smartrobolab/Coco_Desk_Buddy/coco_voice_c3/images/coco_voice_c3_bending_template.pdf

### COCO VOICE C3 - 1:1 bending template

Print at 100 % (no 'fit to page'). Check: the 50 mm ruler below must measure 50 mm.

50 mm

FRONT rectangle + divider (1.2 mm)

BACK rectangle + divider (1.2 mm)

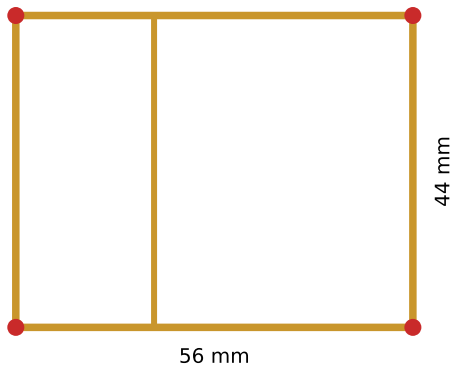
[picture p65: figure]
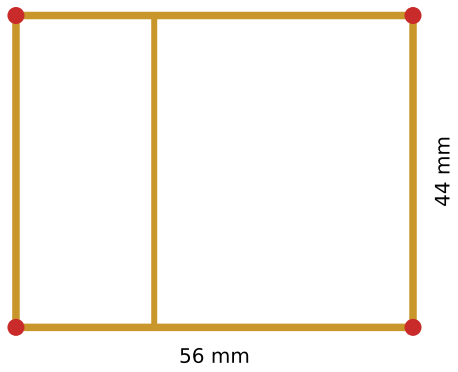
[picture p66: figure]

Red dots = 90° bends. Start a rectangle in the middle of the bottom side so the joint is hidden.

strut 30 mm x4 (1.2 mm)

divider 44 mm x2 (1.2 mm)

seat / floor bar 36.5 mm (see case drawing)

battery ring Ø17.2 mm x2 - wrap the wire around a 16 mm rod (a spare 16340 in its wrap works) and leave a 3 mm tab.

OLED outline 27.3 x 27.8 mm with its 4 mounting holes.
Measure your module: hole spacing varies (about 23 x 24 mm). Posts: 0.9 mm wire through each hole, soldered to the front frame.
