smartrobolab/Coco_Desk_Buddy/coco_touch_advance/yeti_403035/images/coco_yeti_render.png

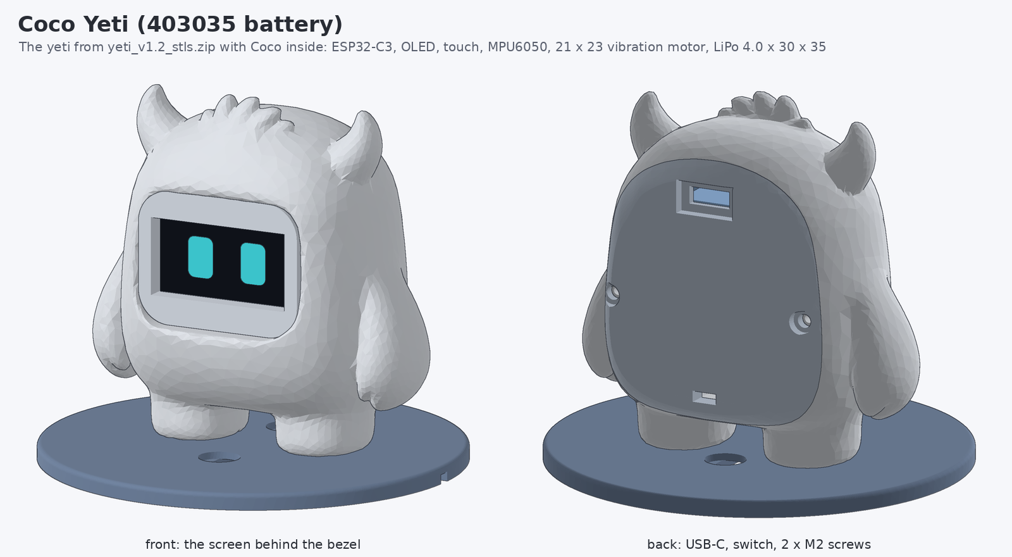
coco_touch_advance/yeti_403035/images/coco_yeti_render.png
