smartrobolab/Coco_Desk_Buddy/coco_touch_advance/yeti_403048/images/coco_yeti_colour_options.png

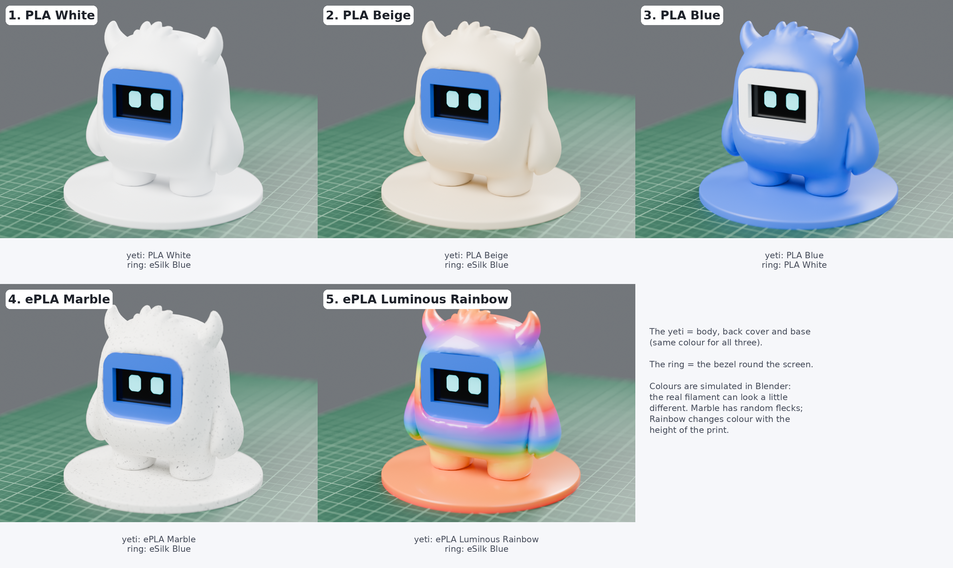
coco_touch_advance/yeti_403048/images/coco_yeti_colour_options.png
