smartrobolab/Coco_Desk_Buddy/shared/images/screens/card_boot.gif

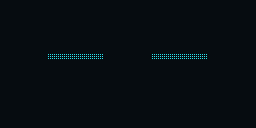
shared/images/screens/card_boot.gif
