smartrobolab/Coco_Desk_Buddy/shared/images/screens/card_boot.png

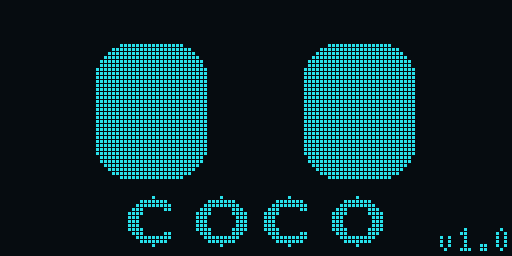
shared/images/screens/card_boot.png
