smartrobolab/Coco_Desk_Buddy/shared/images/screens/card_clock.png

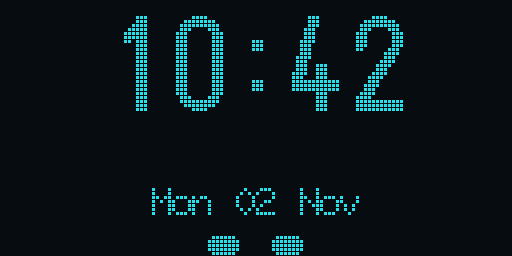
shared/images/screens/card_clock.png
