smartrobolab/Coco_Desk_Buddy/shared/images/screens/card_hold.png

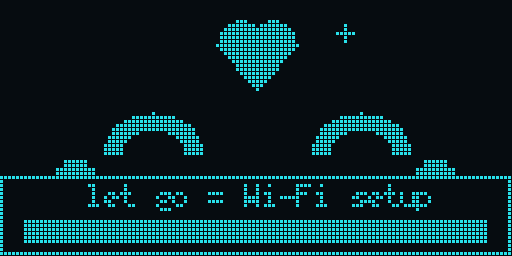
shared/images/screens/card_hold.png
