smartrobolab/Coco_Desk_Buddy/shared/images/screens/card_noweather.png

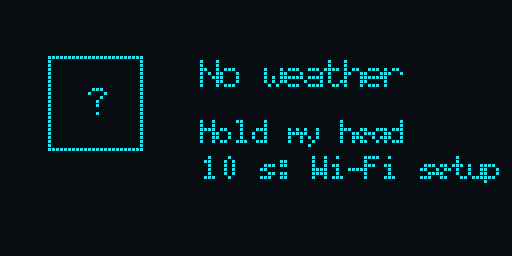
shared/images/screens/card_noweather.png
