smartrobolab/Coco_Desk_Buddy/shared/images/screens/card_status.png

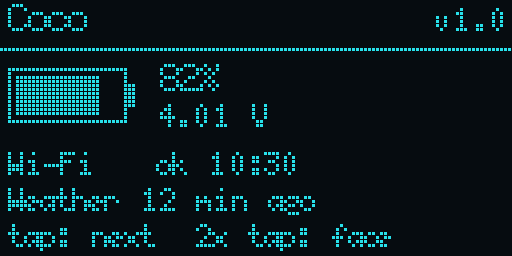
shared/images/screens/card_status.png
