smartrobolab/Coco_Desk_Buddy/shared/images/screens/card_weather-clear.gif

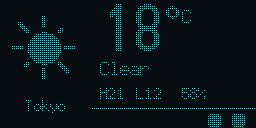
shared/images/screens/card_weather-clear.gif
