smartrobolab/Coco_Desk_Buddy/shared/images/screens/card_weather-fog.png

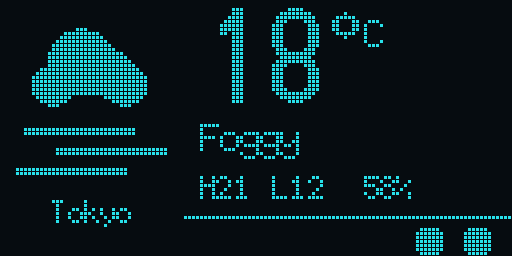
shared/images/screens/card_weather-fog.png
