smartrobolab/Coco_Desk_Buddy/shared/images/screens/card_weather-night.png

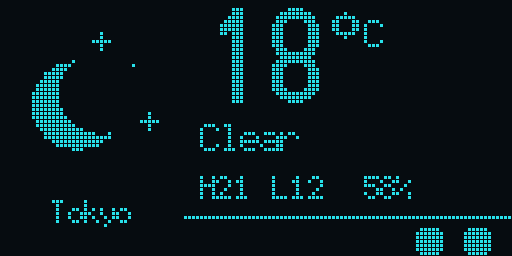
shared/images/screens/card_weather-night.png
