smartrobolab/Coco_Desk_Buddy/shared/images/screens/card_weather-partly.png

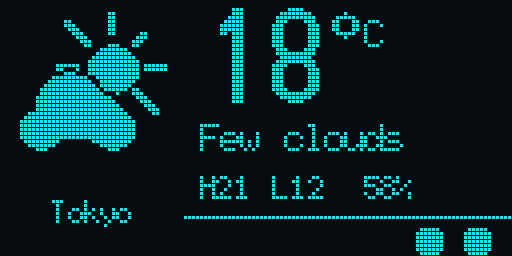
shared/images/screens/card_weather-partly.png
