smartrobolab/Coco_Desk_Buddy/shared/images/screens/card_weather-snow.png

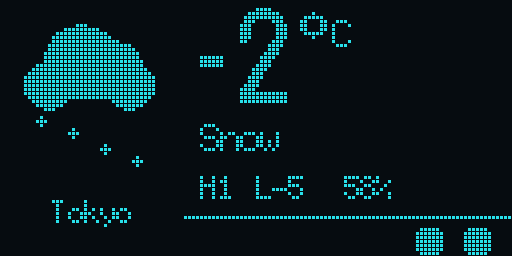
shared/images/screens/card_weather-snow.png
