smartrobolab/Coco_Desk_Buddy/shared/images/screens/card_wifi2.png

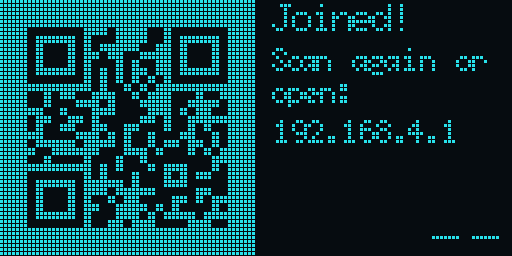
shared/images/screens/card_wifi2.png
