smartrobolab/Coco_Desk_Buddy/shared/images/screens/card_wifi.png

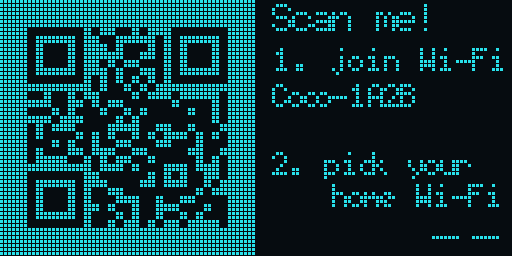
shared/images/screens/card_wifi.png
