smartrobolab/Coco_Desk_Buddy/shared/images/screens/card_wififail.png

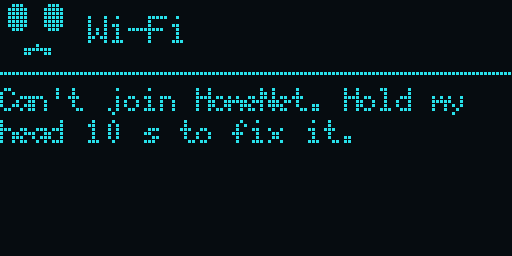
shared/images/screens/card_wififail.png
