smartrobolab/Coco_Desk_Buddy/shared/images/screens/face_angry.png

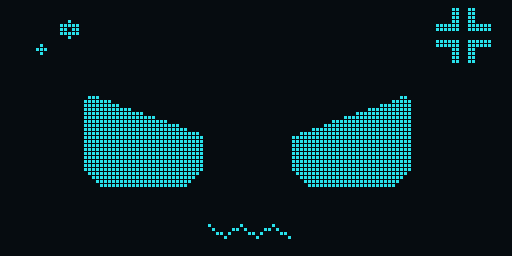
shared/images/screens/face_angry.png
