smartrobolab/Coco_Desk_Buddy/shared/images/screens/face_anime_love.gif

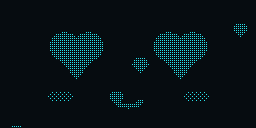
shared/images/screens/face_anime_love.gif
