smartrobolab/Coco_Desk_Buddy/shared/images/screens/face_anime_love.png

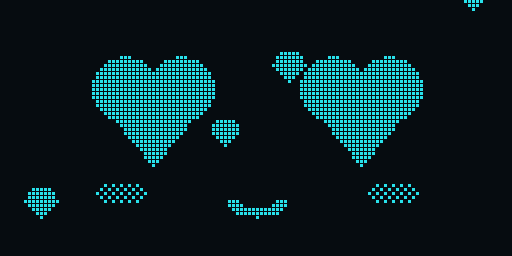
shared/images/screens/face_anime_love.png
