smartrobolab/Coco_Desk_Buddy/shared/images/screens/face_crying.png

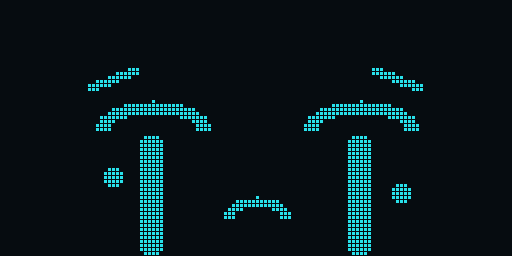
shared/images/screens/face_crying.png
