smartrobolab/Coco_Desk_Buddy/shared/images/screens/face_cute.png

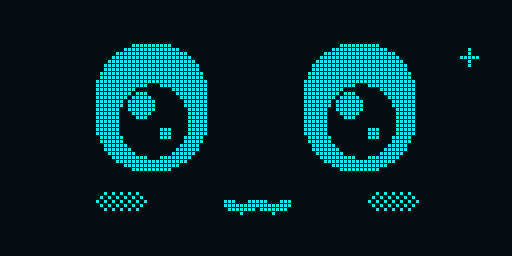
shared/images/screens/face_cute.png
