smartrobolab/Coco_Desk_Buddy/shared/images/screens/face_dizzy.png

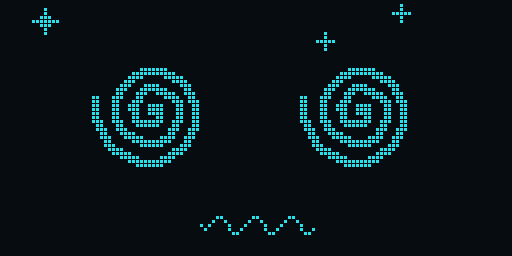
shared/images/screens/face_dizzy.png
