smartrobolab/Coco_Desk_Buddy/shared/images/screens/face_eating.gif

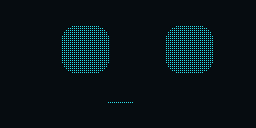
shared/images/screens/face_eating.gif
