smartrobolab/Coco_Desk_Buddy/shared/images/screens/face_eating.png

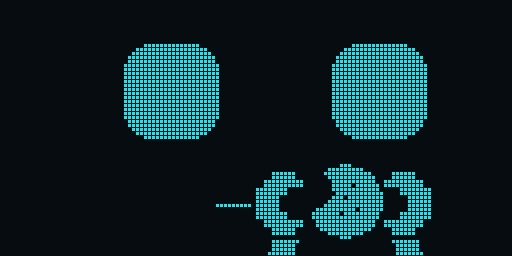
shared/images/screens/face_eating.png
