smartrobolab/Coco_Desk_Buddy/shared/images/screens/face_fire.png

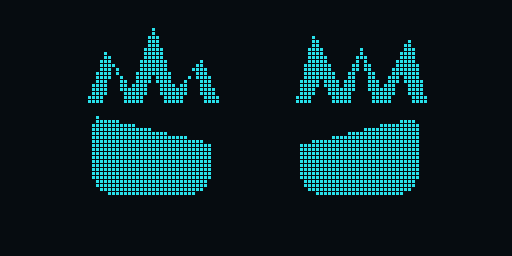
shared/images/screens/face_fire.png
