smartrobolab/Coco_Desk_Buddy/shared/images/screens/face_happy.png

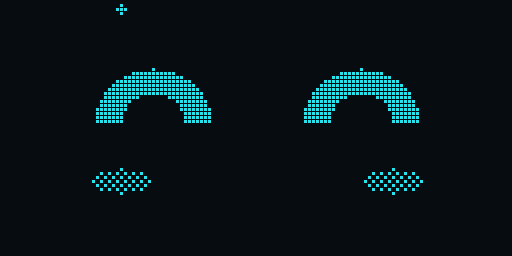
shared/images/screens/face_happy.png
