smartrobolab/Coco_Desk_Buddy/shared/images/screens/face_kissou.png

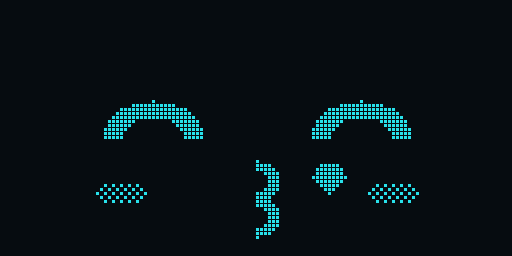
shared/images/screens/face_kissou.png
