smartrobolab/Coco_Desk_Buddy/shared/images/screens/face_low_battery.png

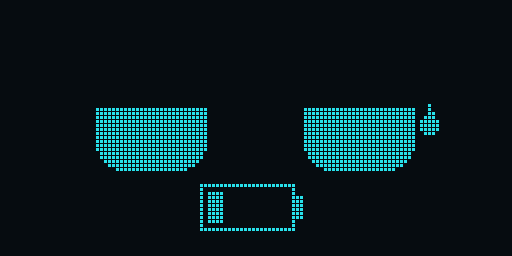
shared/images/screens/face_low_battery.png
