smartrobolab/Coco_Desk_Buddy/shared/images/screens/face_mini_love.png

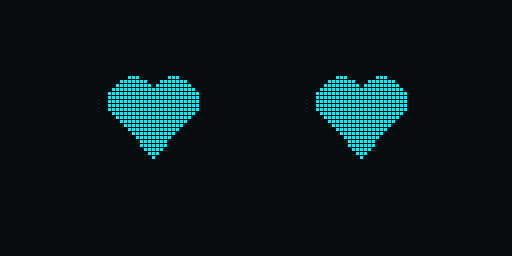
shared/images/screens/face_mini_love.png
