smartrobolab/Coco_Desk_Buddy/shared/images/screens/face_music.png

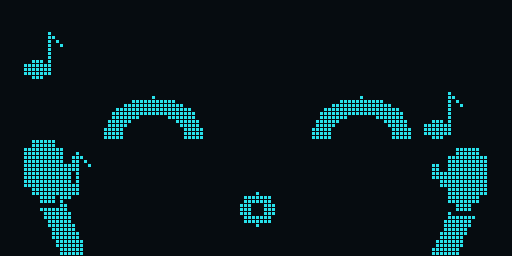
shared/images/screens/face_music.png
