smartrobolab/Coco_Desk_Buddy/shared/images/screens/face_neutral.gif

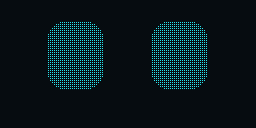
shared/images/screens/face_neutral.gif
