smartrobolab/Coco_Desk_Buddy/shared/images/screens/face_playing.png

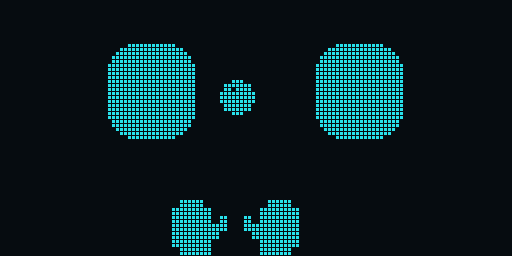
shared/images/screens/face_playing.png
