smartrobolab/Coco_Desk_Buddy/shared/images/screens/face_sad.png

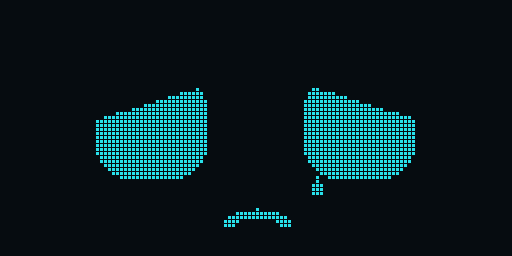
shared/images/screens/face_sad.png
