smartrobolab/Coco_Desk_Buddy/shared/images/screens/face_serious.png

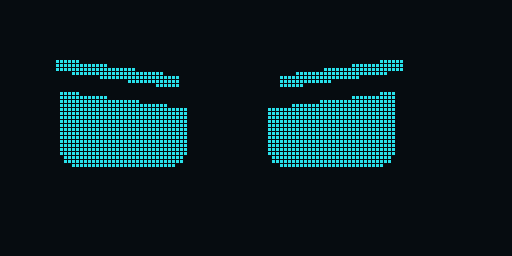
shared/images/screens/face_serious.png
