smartrobolab/Coco_Desk_Buddy/shared/images/screens/face_singing.png

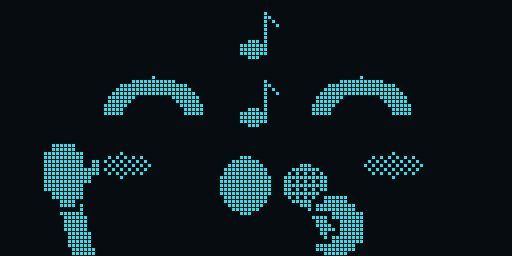
shared/images/screens/face_singing.png
