smartrobolab/Coco_Desk_Buddy/shared/images/screens/face_sleeping.png

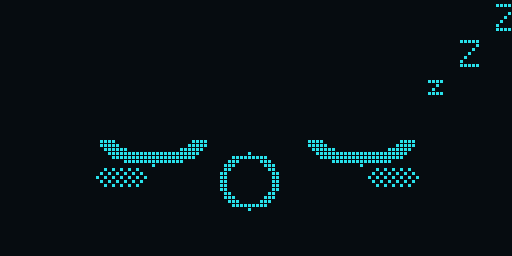
shared/images/screens/face_sleeping.png
