smartrobolab/Coco_Desk_Buddy/shared/images/screens/face_sleepy.png

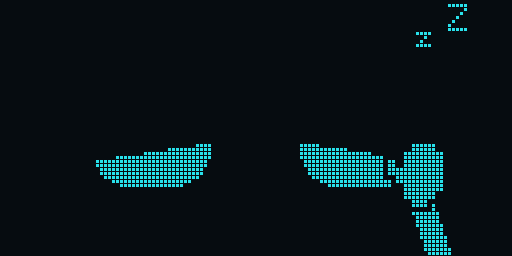
shared/images/screens/face_sleepy.png
