smartrobolab/Coco_Desk_Buddy/shared/images/screens/face_surprised.png

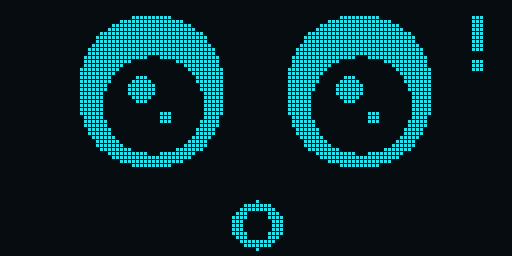
shared/images/screens/face_surprised.png
