smartrobolab/Coco_Desk_Buddy/shared/images/screens/face_yawn.png

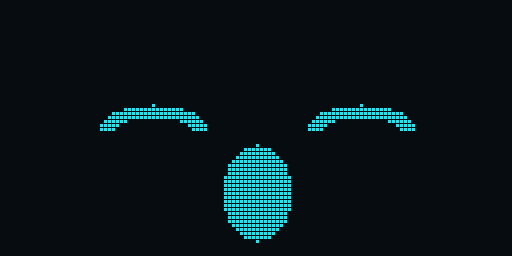
shared/images/screens/face_yawn.png
