smartrobolab/Coco_Desk_Buddy/coco_voice_c3/cad/coco_voice_c3_full.stl

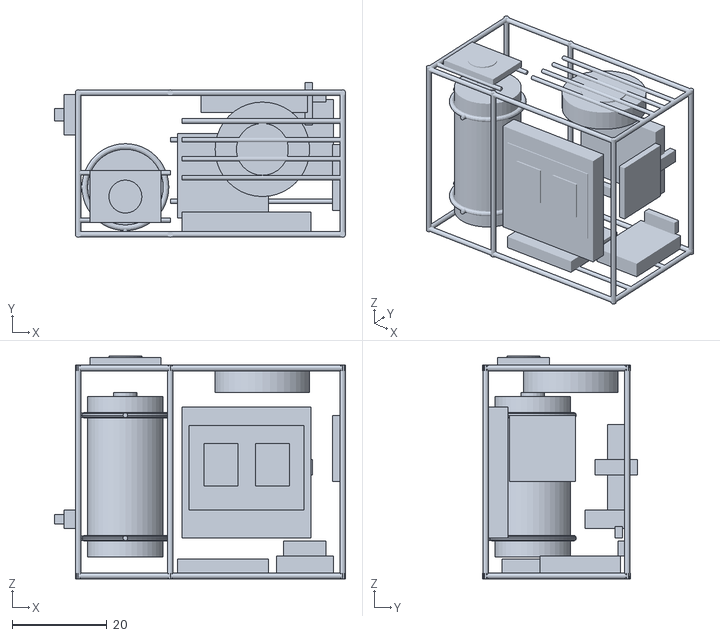
[picture p109: CAD file, 2026-11-02]
coco_voice_c3/cad/coco_voice_c3_full.stl
61.6 x 32.7 x 47.1
