smartrobolab/Coco_Desk_Buddy/coco_touch/cad/coco_touch_full.stl

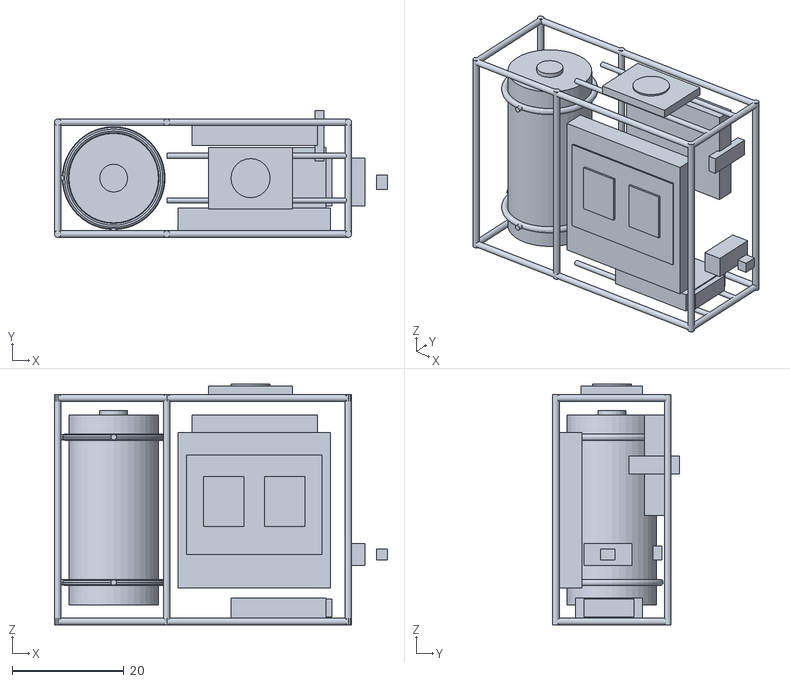
[picture p110: CAD file, 2026-11-02]
coco_touch/cad/coco_touch_full.stl
59.6 x 22.7 x 43.1
