smartrobolab/Coco_Desk_Buddy/coco_voice_s3/cad/coco_voice_s3_hw747_esp32s3_full.stl

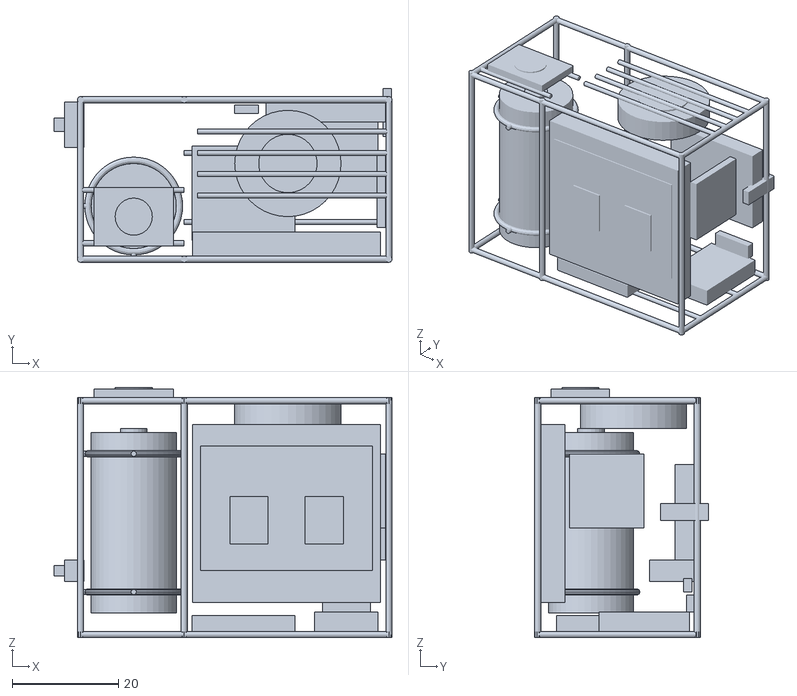
[picture p111: CAD file, 2026-11-03]
coco_voice_s3/cad/coco_voice_s3_hw747_esp32s3_full.stl
63.6 x 32.7 x 47.1
