smartrobolab/Coco_Desk_Buddy/coco_touch/cad/coco_touch_frame.stl

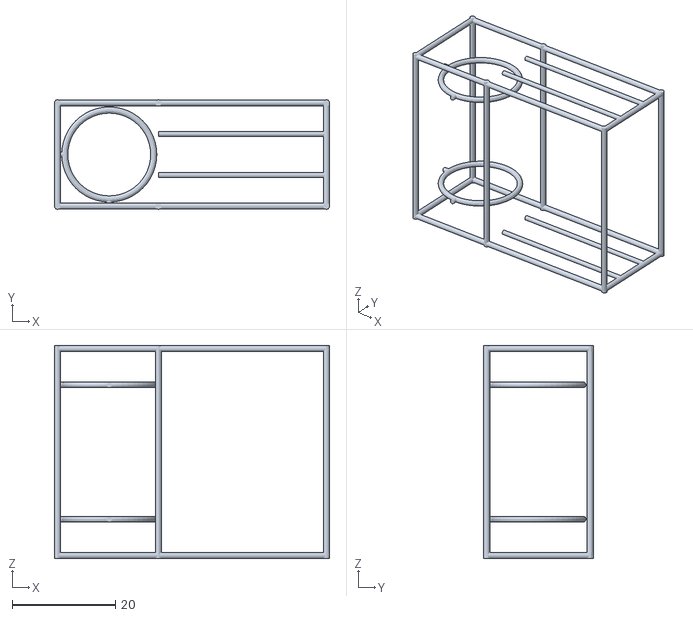
[picture p112: CAD file, 2026-11-02]
coco_touch/cad/coco_touch_frame.stl
53.2 x 21.2 x 41.2
