smartrobolab/Coco_Desk_Buddy/coco_touch_advance/yeti/cad/coco_yeti_base_plain.stl

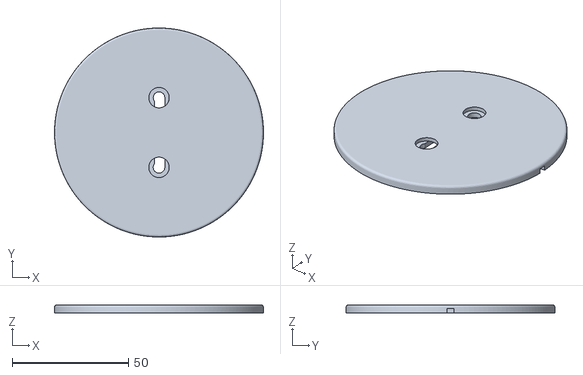
[picture p113: CAD file, 2026-11-04]
coco_touch_advance/yeti/cad/coco_yeti_base_plain.stl
90.0 x 90.0 x 3.50
