smartrobolab/Coco_Desk_Buddy/coco_touch_advance/yeti_403035/cad/coco_yeti_bezel_096.stl

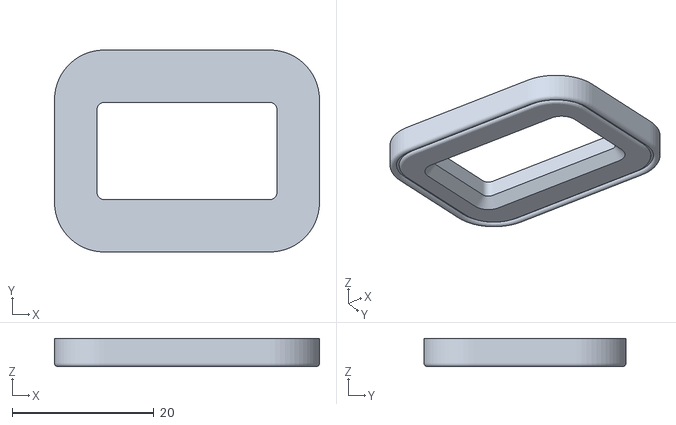
[picture p114: CAD file, 2026-11-04]
coco_touch_advance/yeti_403035/cad/coco_yeti_bezel_096.stl
37.4 x 28.5 x 4.00
