smartrobolab/Coco_Desk_Buddy/coco_touch_advance/yeti_403048/cad/coco_yeti_base_plain.stl

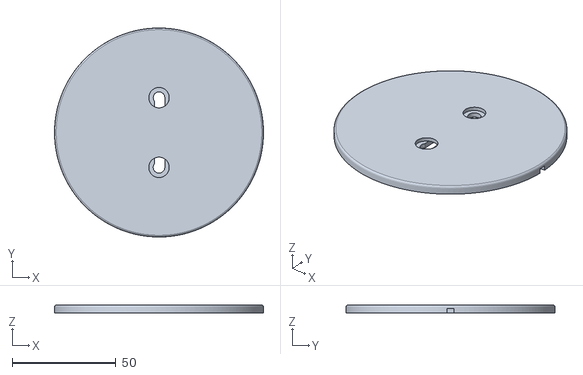
[picture p115: CAD file, 2026-11-04]
coco_touch_advance/yeti_403048/cad/coco_yeti_base_plain.stl
100.8 x 100.8 x 3.87
