smartrobolab/Coco_Desk_Buddy/coco_voice_s3/cad/coco_voice_s3_hw747_esp32s3_frame.stl

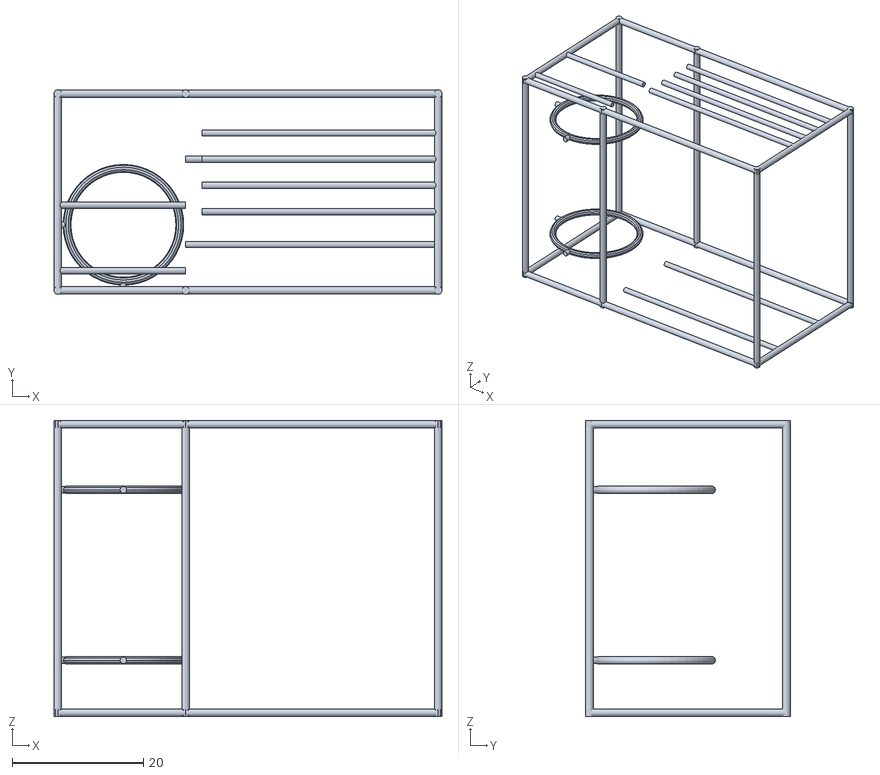
[picture p116: CAD file, 2026-11-03]
coco_voice_s3/cad/coco_voice_s3_hw747_esp32s3_frame.stl
59.2 x 31.2 x 45.2
