smartrobolab/Coco_Desk_Buddy/coco_touch_advance/yeti/cad/coco_yeti_back_cover.stl

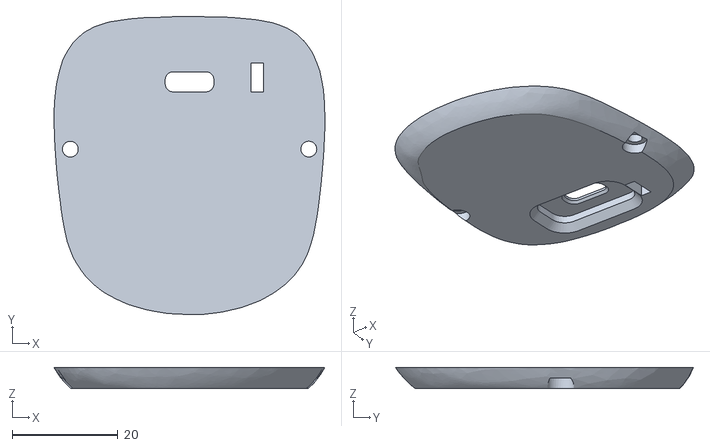
[picture p117: CAD file, 2026-11-04]
coco_touch_advance/yeti/cad/coco_yeti_back_cover.stl
51.1 x 56.2 x 4.00
