smartrobolab/Coco_Desk_Buddy/coco_touch_advance/yeti_2x502030/cad/coco_yeti_chassis_13.stl

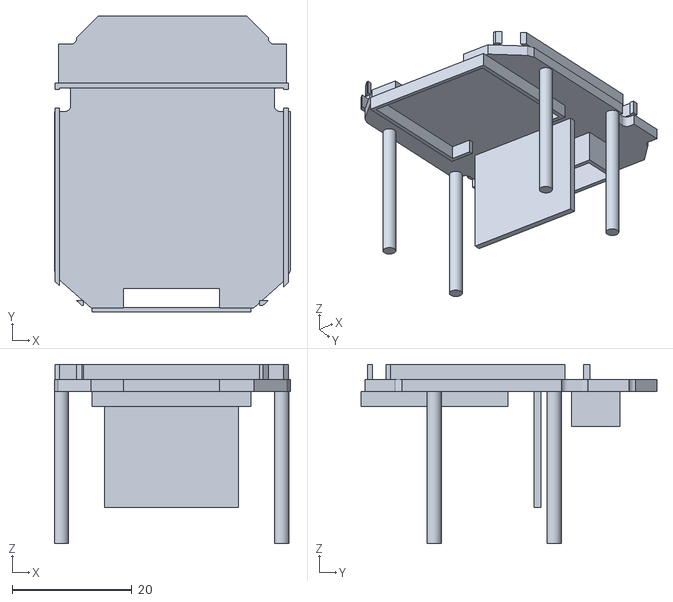
[picture p118: CAD file, 2026-11-04]
coco_touch_advance/yeti_2x502030/cad/coco_yeti_chassis_13.stl
39.4 x 49.4 x 29.9
