smartrobolab/Coco_Desk_Buddy/coco_touch_advance/yeti_403048/cad/coco_yeti_back_cover.stl

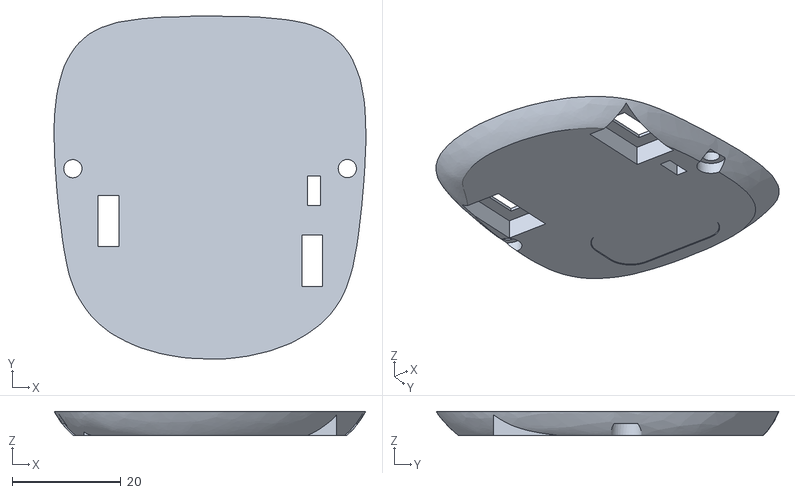
[picture p120: CAD file, 2026-11-04]
coco_touch_advance/yeti_403048/cad/coco_yeti_back_cover.stl
57.3 x 63.0 x 4.48
