smartrobolab/Coco_Desk_Buddy/coco_voice_c3/cad/coco_voice_c3_frame.stl

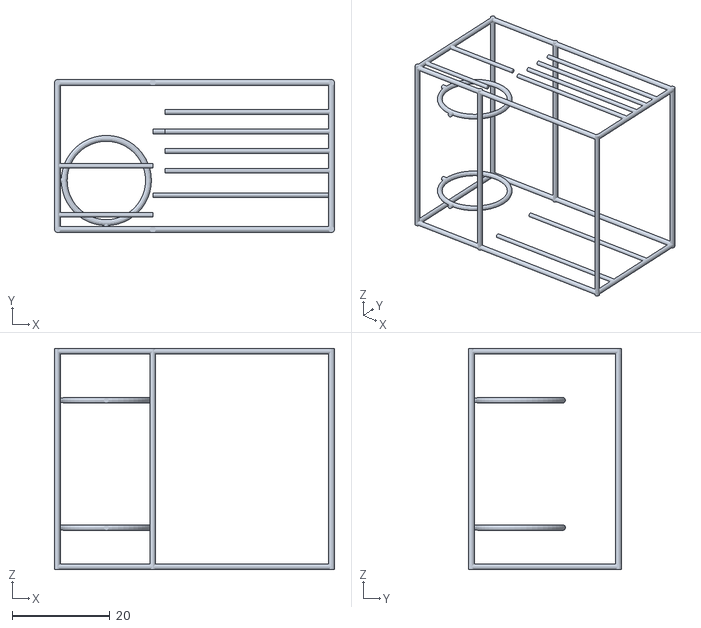
[picture p121: CAD file, 2026-11-02]
coco_voice_c3/cad/coco_voice_c3_frame.stl
57.2 x 31.2 x 45.2
