smartrobolab/Coco_Desk_Buddy/coco_touch_advance/yeti/cad/coco_yeti_body.stl

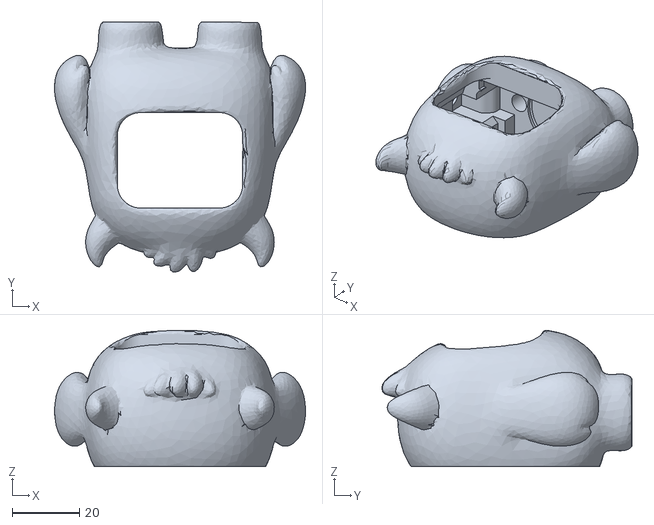
[picture p122: CAD file, 2026-11-04]
coco_touch_advance/yeti/cad/coco_yeti_body.stl
74.9 x 74.7 x 40.6
