smartrobolab/Coco_Desk_Buddy/coco_touch_advance/yeti_2x502030/cad/coco_yeti_chassis_096.stl

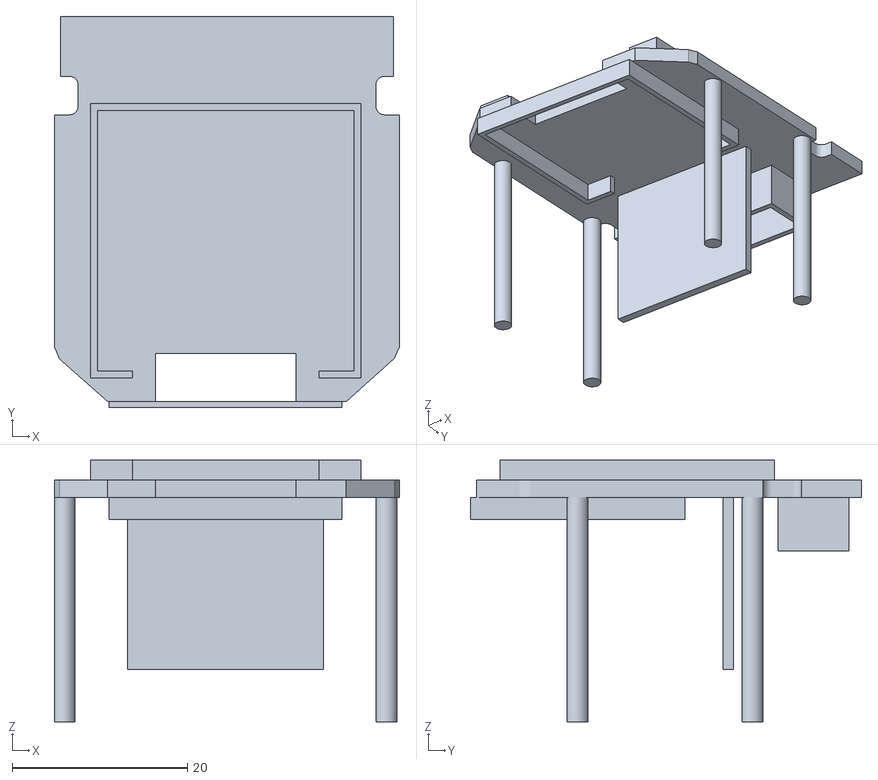
[picture p123: CAD file, 2026-11-04]
coco_touch_advance/yeti_2x502030/cad/coco_yeti_chassis_096.stl
39.4 x 44.7 x 29.9
