smartrobolab/Coco_Desk_Buddy/coco_touch_advance/yeti/cad/coco_yeti_parts_13.stl

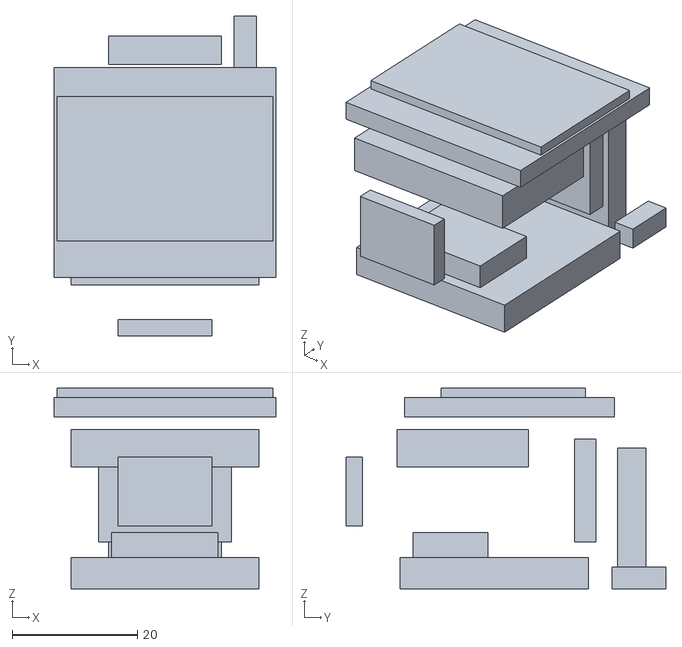
[picture p128: CAD file, 2026-11-04]
coco_touch_advance/yeti/cad/coco_yeti_parts_13.stl
35.4 x 51.0 x 32.0
