smartrobolab/Coco_Desk_Buddy/coco_touch_advance/yeti_2x502030/cad/coco_yeti_parts_13.stl

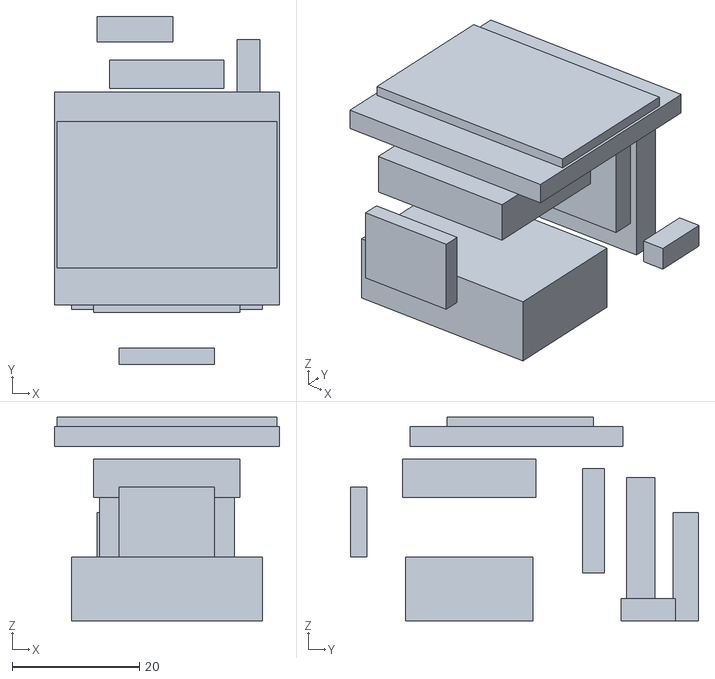
[picture p129: CAD file, 2026-11-04]
coco_touch_advance/yeti_2x502030/cad/coco_yeti_parts_13.stl
35.4 x 54.6 x 32.0
