smartrobolab/Coco_Desk_Buddy/coco_touch_advance/yeti_403035/cad/coco_yeti_chassis_13.stl

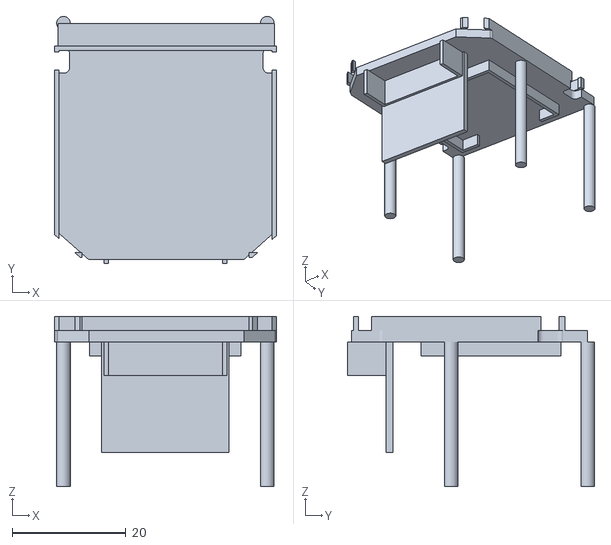
[picture p130: CAD file, 2026-11-04]
coco_touch_advance/yeti_403035/cad/coco_yeti_chassis_13.stl
39.0 x 43.4 x 29.9
