smartrobolab/Coco_Desk_Buddy/coco_touch_advance/yeti_403048/cad/coco_yeti_bezel_096.stl

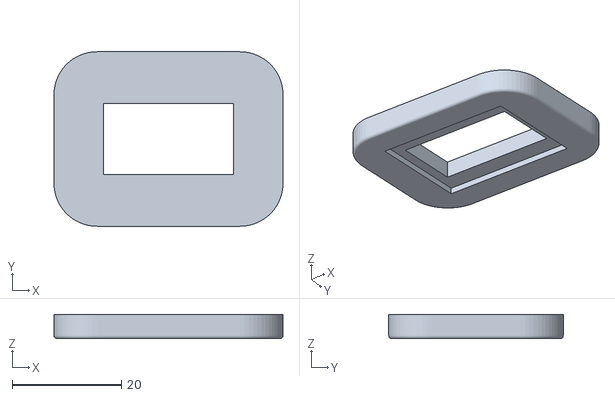
[picture p131: CAD file, 2026-11-04]
coco_touch_advance/yeti_403048/cad/coco_yeti_bezel_096.stl
41.9 x 31.9 x 4.48
