smartrobolab/Coco_Desk_Buddy/coco_touch_advance/yeti/cad/coco_yeti_parts_096.stl

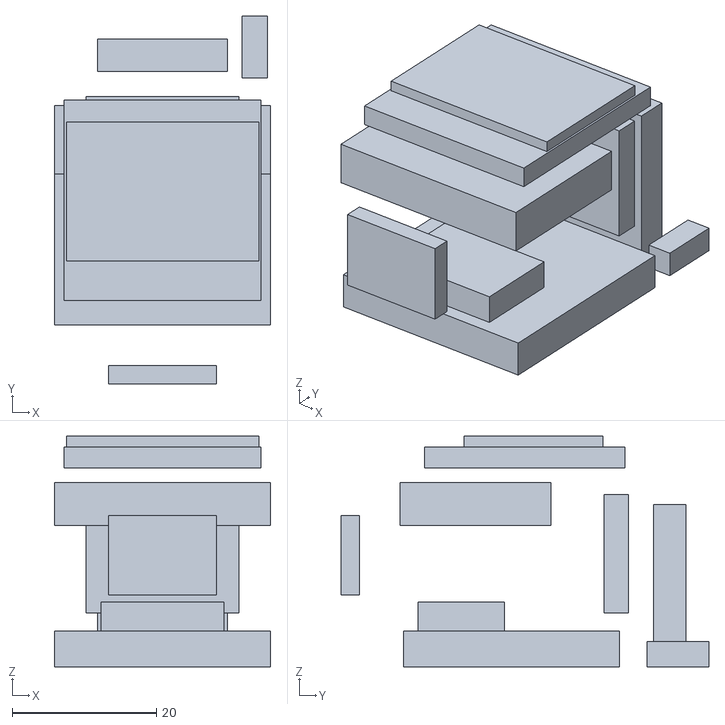
[picture p132: CAD file, 2026-11-04]
coco_touch_advance/yeti/cad/coco_yeti_parts_096.stl
30.0 x 51.0 x 32.0
