smartrobolab/Coco_Desk_Buddy/coco_touch_advance/yeti/cad/coco_yeti_bezel_13.stl

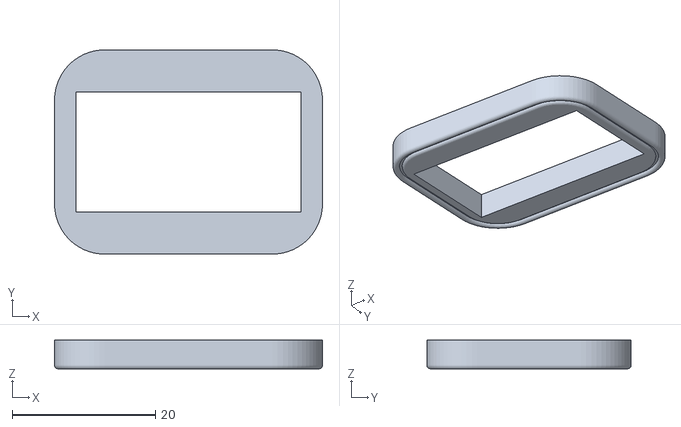
[picture p134: CAD file, 2026-11-04]
coco_touch_advance/yeti/cad/coco_yeti_bezel_13.stl
37.4 x 28.5 x 4.00
