smartrobolab/Coco_Desk_Buddy/coco_touch_advance/yeti_403048/cad/coco_yeti_parts_096.stl

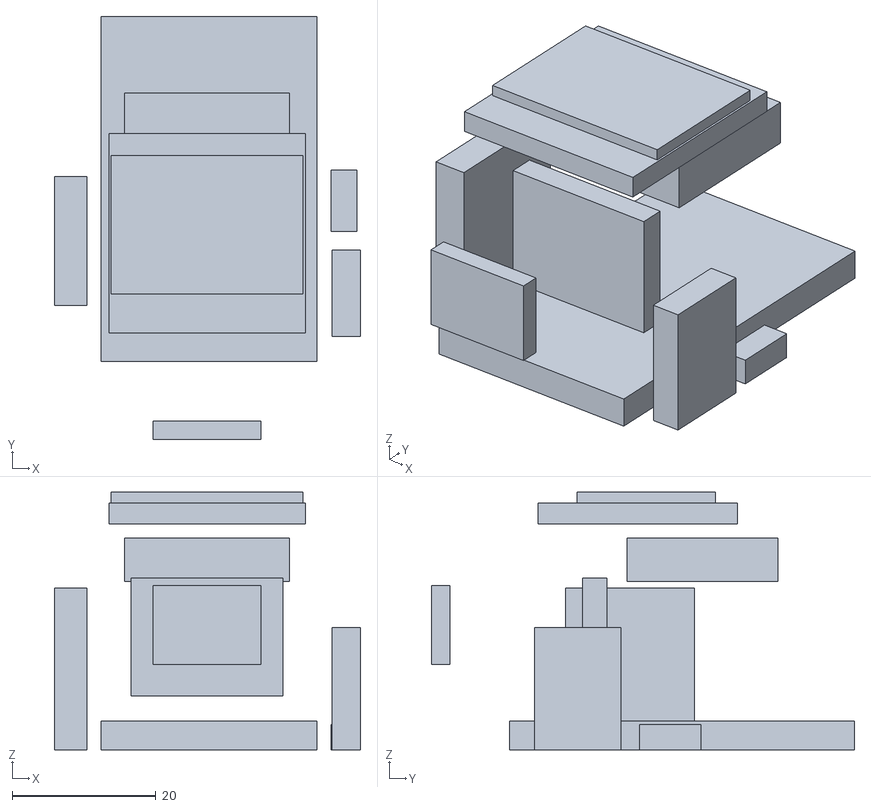
[picture p136: CAD file, 2026-11-04]
coco_touch_advance/yeti_403048/cad/coco_yeti_parts_096.stl
42.6 x 58.9 x 35.8
