smartrobolab/Coco_Desk_Buddy/coco_touch_advance/yeti_2x502030/cad/coco_yeti_parts_096.stl

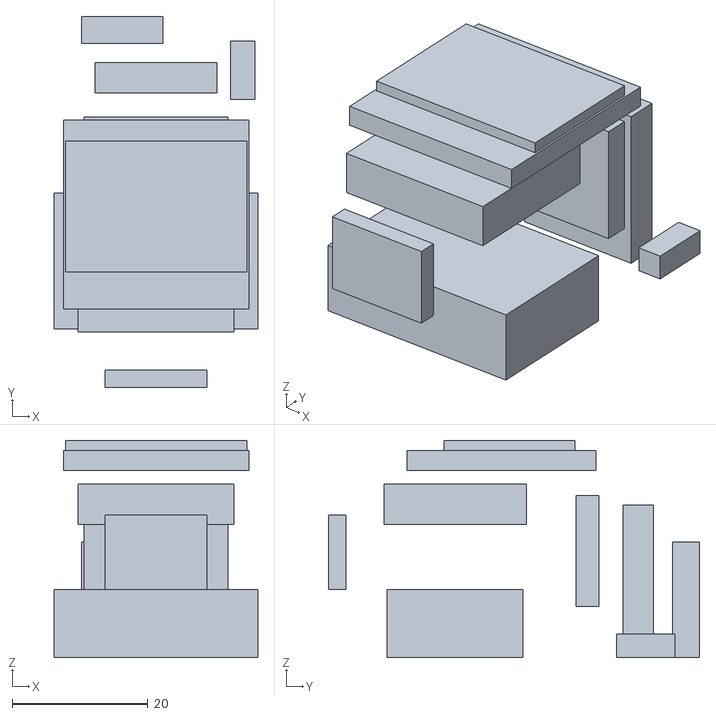
[picture p138: CAD file, 2026-11-04]
coco_touch_advance/yeti_2x502030/cad/coco_yeti_parts_096.stl
30.0 x 54.6 x 32.0
