smartrobolab/Coco_Desk_Buddy/coco_touch_advance/yeti_403035/cad/coco_yeti_chassis_096.stl

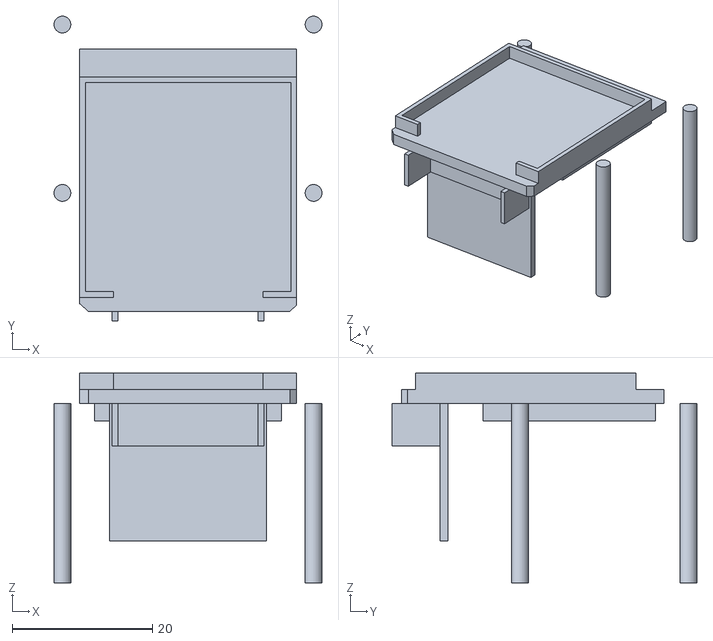
[picture p139: CAD file, 2026-11-04]
coco_touch_advance/yeti_403035/cad/coco_yeti_chassis_096.stl
38.2 x 43.4 x 29.9
