smartrobolab/Coco_Desk_Buddy/coco_touch_advance/yeti_403048/cad/coco_yeti_chassis_13.stl

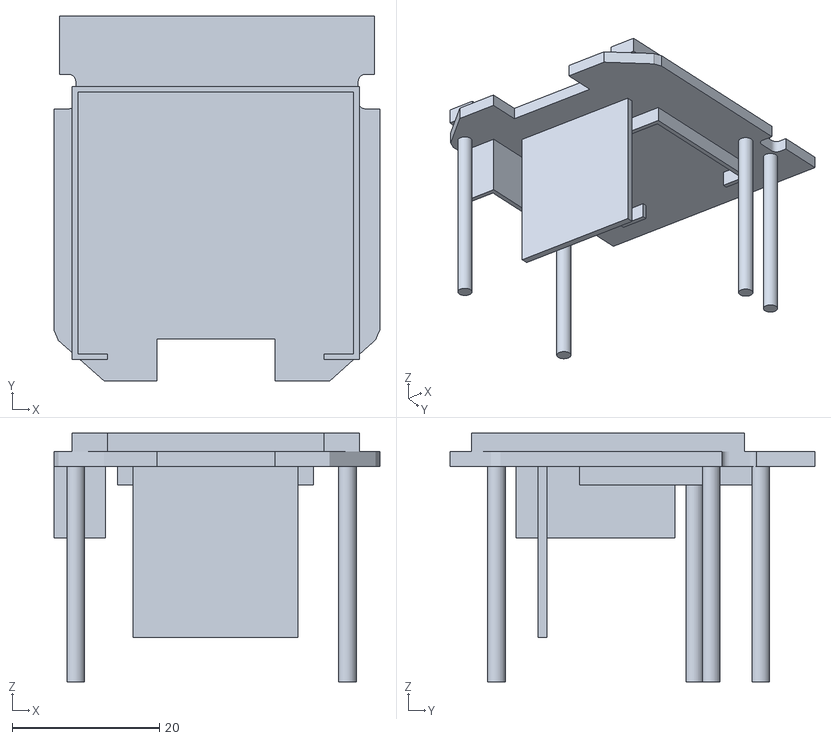
[picture p140: CAD file, 2026-11-04]
coco_touch_advance/yeti_403048/cad/coco_yeti_chassis_13.stl
44.2 x 49.5 x 33.7
