smartrobolab/Coco_Desk_Buddy/coco_touch_advance/yeti/cad/coco_yeti_chassis_096.stl

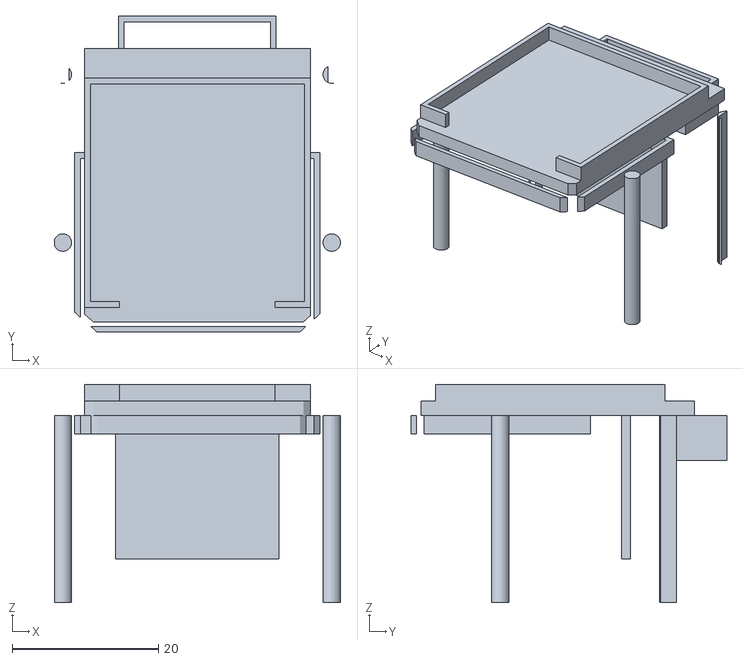
[picture p141: CAD file, 2026-11-04]
coco_touch_advance/yeti/cad/coco_yeti_chassis_096.stl
39.1 x 43.2 x 29.9
