smartrobolab/Coco_Desk_Buddy/coco_touch_advance/yeti_403048/cad/coco_yeti_body.stl

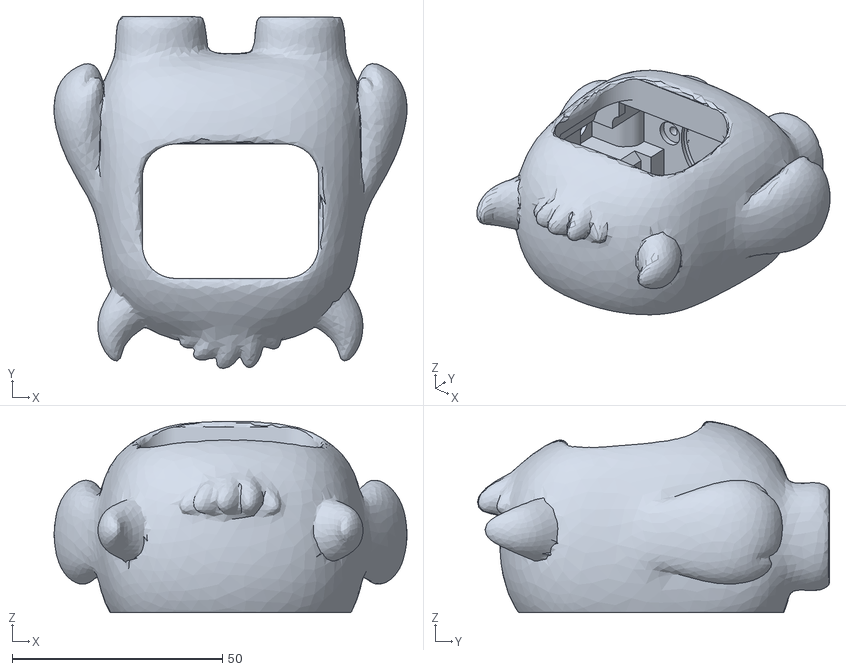
[picture p143: CAD file, 2026-11-04]
coco_touch_advance/yeti_403048/cad/coco_yeti_body.stl
83.9 x 83.7 x 45.5
