smartrobolab/Coco_Desk_Buddy/(list of files, cad)

Other CAD files:
coco_voice_s3/cad/coco_voice_s3_full.stl
coco_touch_advance/yeti_2x502030/cad/coco_yeti_base_plain.stl
coco_voice_s3/cad/coco_voice_s3_frame.stl
coco_touch_advance/yeti_2x502030/cad/coco_yeti_back_cover.stl
coco_touch_advance/yeti_403035/cad/coco_yeti_back_cover.stl
coco_touch_advance/yeti_2x502030/cad/print/coco_yeti_back_cover.stl
coco_touch_advance/yeti_2x502030/cad/print/coco_yeti_base_plain.stl
coco_touch_advance/yeti_2x502030/cad/print/coco_yeti_bezel_096.stl
coco_touch_advance/yeti_2x502030/cad/print/coco_yeti_bezel_13.stl
coco_touch_advance/yeti_2x502030/cad/print/coco_yeti_body.stl
coco_touch_advance/yeti_2x502030/cad/print/coco_yeti_chassis_096.stl
coco_touch_advance/yeti_2x502030/cad/print/coco_yeti_chassis_13.stl
coco_touch_advance/yeti_403048/cad/print/coco_yeti_back_cover.stl
coco_touch_advance/yeti_403048/cad/print/coco_yeti_base_plain.stl
coco_touch_advance/yeti_403048/cad/print/coco_yeti_bezel_096.stl
coco_touch_advance/yeti_403048/cad/print/coco_yeti_bezel_13.stl
coco_touch_advance/yeti_403048/cad/print/coco_yeti_body.stl
coco_touch_advance/yeti_403048/cad/print/coco_yeti_chassis_096.stl
coco_touch_advance/yeti_403048/cad/print/coco_yeti_chassis_13.stl
