smartrobolab/Coco_Desk_Buddy/coco_voice_s3/images/coco_voice_s3_devkit_wiring.png

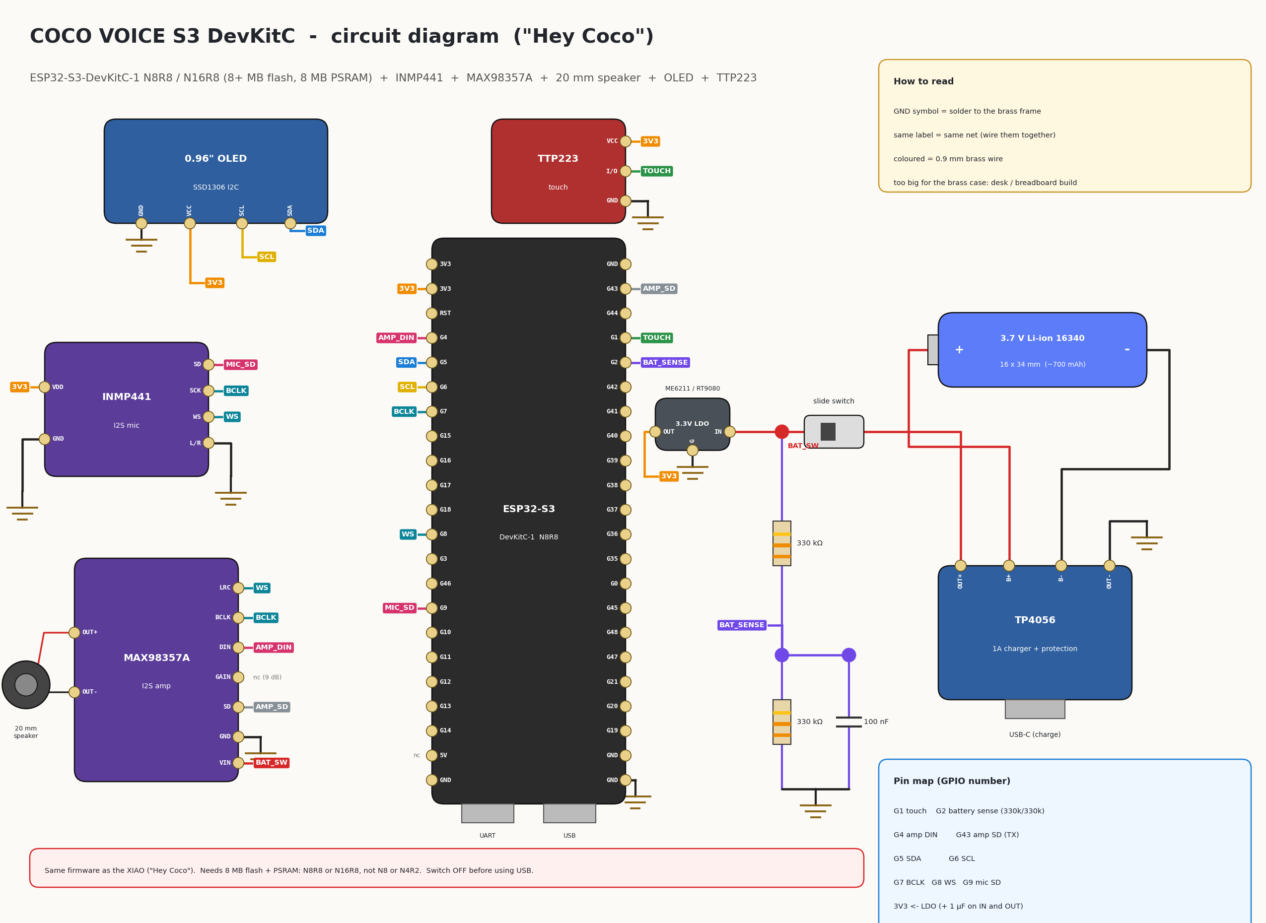
coco_voice_s3/images/coco_voice_s3_devkit_wiring.png
