smartrobolab/Coco_Desk_Buddy/coco_touch_advance/yeti_2x502030/cad/verify_report.txt

Coco Yeti print check: yeti_2x502030 (scale 1.00)

1. Printable files (cad/print/, as they go on the print bed)
   coco_yeti_back_cover.stl         OK  closed solid,  51.1 x  56.2 x   4.0 mm,   7.8 cm3, ~   8 g PLA
   coco_yeti_base_plain.stl         OK  closed solid,  90.0 x  90.0 x   3.5 mm,  21.1 cm3, ~  22 g PLA
   coco_yeti_bezel_096.stl          OK  closed solid,  37.4 x  28.5 x   4.0 mm,   2.6 cm3, ~   3 g PLA
   coco_yeti_bezel_13.stl           OK  closed solid,  37.4 x  28.5 x   4.0 mm,   1.6 cm3, ~   2 g PLA
   coco_yeti_body.stl               OK  closed solid,  74.9 x  74.7 x  40.6 mm,  37.8 cm3, ~  40 g PLA
   coco_yeti_chassis_096.stl        OK  closed solid,  39.4 x  44.7 x  29.9 mm,   4.8 cm3, ~   5 g PLA
   coco_yeti_chassis_13.stl         OK  closed solid,  39.4 x  49.4 x  29.9 mm,   5.1 cm3, ~   5 g PLA

2. Fit (1 mm round every part)
   13 screen: OK
   096 screen: OK

3. Yeti on the base
   overlap yeti / base: 0.000 mm3 (OK)
   foot at x   15.0, y   4.3: pilot hole open, leg 100% solid round it, base hole below it yes
   foot at x  -15.0, y   4.3: pilot hole open, leg 100% solid round it, base hole below it yes

4. USB-C ports (big plug: head 15 x 9 mm, metal 6.65 mm), pushed fully into each socket
   ESP32-C3 (program)   socket at x    0.0, y   15.3: plug head clear, metal goes 6.05 mm into the socket, socket behind the slot
   TP4056 (charge)      socket at x   -5.0, y   21.4: plug head clear, metal goes 6.05 mm into the socket, socket behind the slot
   both cables at once: no, one at a time (the plug heads would touch)

5. Stability (1.3" version; PLA, parts as weighed typically)
   total about 86 g, centre of mass at x 0.1, y 4.4 (back +), z 39.6 mm above the desk
   on its feet alone: centre of mass inside the feet, 10.2 mm from the nearest edge, tips over at ~16 deg of tilt
   screwed to the base: 44.9 mm to the base edge, tips over at ~49 deg of tilt

RESULT: all checks passed
