smartrobolab/Coco_Desk_Buddy/coco_touch_advance/yeti_403048/cad/verify_report.txt

Coco Yeti print check: yeti_403048 (scale 1.12)

1. Printable files (cad/print/, as they go on the print bed)
   coco_yeti_back_cover.stl         OK  closed solid,  57.3 x  63.0 x   4.5 mm,  11.3 cm3, ~  12 g PLA
   coco_yeti_base_plain.stl         OK  closed solid, 100.8 x 100.8 x   3.9 mm,  29.8 cm3, ~  31 g PLA
   coco_yeti_bezel_096.stl          OK  closed solid,  41.9 x  31.9 x   4.5 mm,   4.1 cm3, ~   4 g PLA
   coco_yeti_bezel_13.stl           OK  closed solid,  41.9 x  31.9 x   4.5 mm,   3.0 cm3, ~   3 g PLA
   coco_yeti_body.stl               OK  closed solid,  83.9 x  83.7 x  45.5 mm,  53.0 cm3, ~  56 g PLA
   coco_yeti_chassis_096.stl        OK  closed solid,  44.2 x  49.5 x  33.7 mm,   5.7 cm3, ~   6 g PLA
   coco_yeti_chassis_13.stl         OK  closed solid,  44.2 x  49.5 x  33.7 mm,   5.9 cm3, ~   6 g PLA

2. Fit (1 mm round every part)
   13 screen: OK
   096 screen: OK

3. Yeti on the base
   overlap yeti / base: 0.000 mm3 (OK)
   foot at x   16.8, y   4.8: pilot hole open, leg 100% solid round it, base hole below it yes
   foot at x  -16.8, y   4.8: pilot hole open, leg 100% solid round it, base hole below it yes

4. USB-C ports (big plug: head 15 x 9 mm, metal 6.65 mm), pushed fully into each socket
   ESP32-C3 (program)   socket at x  -18.6, y   -6.7: plug head clear, metal goes 6.05 mm into the socket, socket behind the slot
   TP4056 (charge)      socket at x   18.8, y  -14.0: plug head clear, metal goes 6.05 mm into the socket, socket behind the slot
   both cables at once: yes

5. Stability (1.3" version; PLA, parts as weighed typically)
   total about 107 g, centre of mass at x 0.3, y 5.0 (back +), z 42.8 mm above the desk
   on its feet alone: centre of mass inside the feet, 11.3 mm from the nearest edge, tips over at ~16 deg of tilt
   screwed to the base: 50.0 mm to the base edge, tips over at ~49 deg of tilt

RESULT: all checks passed
