smartrobolab/Coco_Desk_Buddy/coco_touch/firmware/coco_touch/coco_touch.ino

/*
  COCO TOUCH - a tiny brass desk buddy (ESP32-C3 Super Mini or HW-747 ESP32-S3
  Super Mini + 0.96" SSD1306 or 1.3" SH1106 OLED + TTP223)

  Coco lives on the OLED as a pair of animated eyes (Kibo's face engine:
  kibo_faces.cpp). Touch the pad on its head:

    tap            next face (Neutral, Serious, Sleepy, Crying, Sad, Cute, Kissou,
                   Mini Love, Anime Love, Fire, Angry)
    double-tap     menu: Clock & date, Weather, Battery, Faces, Wi-Fi setup (QR),
                   Sleep, Back. In the menu: tap = next item, hold ~1 s = open it,
                   double-tap = close. On a card or the face gallery: tap = next,
                   double-tap = back to the menu. Untouched for 10-12 s: back to the face.
    long press     Love (petting) while you hold
    hold 5 s       deep sleep, screen off (touch to wake)
    hold 10 s      Wi-Fi setup: Coco shows a QR code, join its hotspot with
                   your phone, pick your Wi-Fi, type the password and city
    poke a lot     Angry (6+ quick taps), then Crying (10+)

  When you leave it alone it eats cookies, plays with a ball, dances, sings,
  yawns and shows the clock / weather. After NAP_AFTER_MIN it falls asleep,
  after DEEP_SLEEP_AFTER_MIN more it powers down until you touch it.

  Wi-Fi is on only for a few seconds every WEATHER_REFRESH_MIN minutes to sync
  the time (NTP) and fetch the weather: OpenWeatherMap when an API key is set
  (phone setup page or coco_secrets.h), otherwise open-meteo.com (no key); if
  OpenWeatherMap fails, open-meteo is used. The time zone comes from the
  weather location, so there is nothing to set.

  First boot (nothing saved yet) starts the phone setup by itself. Defaults and
  pins: coco_config.h.   Wiring: coco_touch/images/coco_touch_wiring.png
  Board package: "esp32" by Espressif 3.x, board "ESP32C3 Dev Module" (C3) or
  "ESP32S3 Dev Module" with Flash Size 4MB and PSRAM "QSPI PSRAM" (HW-747),
  USB CDC On Boot "Enabled", Partition Scheme "Huge APP (3MB No OTA/1MB SPIFFS)"
  (the default 1.2 MB app slot is too small). No extra libraries.
  The board is picked from the chip, the screen with OLED_SH1106 in coco_config.h.
*/

#include <Arduino.h>
#include <HTTPClient.h>
#include <WiFi.h>
#include <WiFiClientSecure.h>
#include <esp_sleep.h>
#include <time.h>

#include "coco_cards.h"
#include "coco_config.h"
#include "coco_oled.h"
#include "coco_portal.h"
#include "coco_settings.h"
#include "kibo_faces.h"
#include "kibo_screens.h"

using namespace kibo;

static const char* const kVersion = "v1.1";

// ------------------------------------------------------------------ timings
constexpr uint32_t kFrameMs = 40;          // 25 fps
constexpr uint32_t kBlinkMs = 120;         // blink between two faces
constexpr uint32_t kDoubleTapMs = 300;     // second tap within this -> double-tap
constexpr uint32_t kLongPressMs = 800;     // -> Love
constexpr uint32_t kHoldSleepMs = 5000;    // release after this -> deep sleep
constexpr uint32_t kHoldSetupMs = 10000;   // release after this -> Wi-Fi setup
constexpr uint32_t kTapFaceMs = 6000;      // how long a tapped face stays
constexpr uint32_t kCardIdleMs = 12000;    // cards go back to the face after this
constexpr uint32_t kNapMs = NAP_AFTER_MIN * 60000UL;
constexpr uint32_t kNightNapMs = 60000;
constexpr uint32_t kDeepSleepMs = DEEP_SLEEP_AFTER_MIN * 60000UL;

// ------------------------------------------------------------ shared state
// Kept in RTC memory so deep sleep does not forget the weather.
struct RtcSave {
  uint32_t magic;
  float temp, hi, lo;
  int16_t humidity;
  uint8_t sky, day;
  int64_t fetchedAt;  // epoch seconds, 0 = never
};
RTC_DATA_ATTR RtcSave rtcSave;
constexpr uint32_t kRtcMagic = 0xC0C0C0C0;
RTC_NOINIT_ATTR uint32_t setupRequest;      // survives ESP.restart(): start in Wi-Fi setup
constexpr uint32_t kSetupMagic = 0x5E7A9C0C;

portMUX_TYPE netMux = portMUX_INITIALIZER_UNLOCKED;
coco::Weather weather;          // guarded by netMux
time_t weatherAt = 0;           // guarded by netMux
char wifiText[16] = "off";      // guarded by netMux
volatile bool wifiFailed = false;  // set by the net task, shown once as a notice

// ----------------------------------------------------------------- display
CocoOled oled;
Canvas canvas;
uint8_t lastSent[sizeof(Canvas::buf)];
bool haveSent = false;

// -------------------------------------------------------------- behaviour
enum class Activity : uint8_t { None, Eating, Playing, Music, Sing, Yawn, Clock, Weather, LowBattery };
struct ActivityInfo {
  uint32_t ms;
  uint8_t weight;
};
const ActivityInfo kActivities[] = {
    {0, 0},     // None
    {7000, 3},  // Eating
    {6000, 3},  // Playing
    {6000, 2},  // Music
    {5000, 1},  // Sing
    {3000, 1},  // Yawn
    {6000, 3},  // Clock
    {6000, 3},  // Weather
    {4000, 0},  // LowBattery (weight set when the battery is low)
};
constexpr int kActivityCount = sizeof(kActivities) / sizeof(kActivities[0]);

enum class Card : uint8_t { Clock, Weather, Status, Count };

uint32_t bootAt = 0;
bool booting = true;
bool setupMode = false;
uint32_t setupSince = 0;
uint32_t noticeUntil = 0;
bool showingCards = false;
Card card = Card::Clock;
uint32_t cardSince = 0, cardUntil = 0;

// Menu (double-tap): tap = next item, hold ~1 s = open the item. The items are
// shown in this order; "Battery" opens the status card (battery, Wi-Fi, weather age).
enum class MenuItem : uint8_t { Clock, Weather, Battery, Faces, WifiSetup, Sleep, Back, Count };
const char* const kMenuItems[] = {"Clock & date", "Weather", "Battery", "Faces", "Wi-Fi setup (QR)", "Sleep",
                                  "Back"};
static_assert(sizeof(kMenuItems) / sizeof(kMenuItems[0]) == (int)MenuItem::Count, "one label per item");
constexpr uint32_t kMenuIdleMs = 10000;  // untouched this long -> back to the face
bool menuOpen = false;
int menuSel = 0;
uint32_t menuUntil = 0;
bool menuTookPress = false;  // this press opened a menu item: no Love when it is let go

// Face gallery (menu > Faces): every face, tap = next, its name at the bottom.
bool faceShow = false;
int faceShowIdx = 0;
uint32_t faceShowSince = 0, faceShowUntil = 0;

Face reactionFace = Face::Neutral;
uint32_t reactionUntil = 0;
bool holdingLove = false;

Activity activity = Activity::None;
uint32_t activitySince = 0, activityUntil = 0, nextActivityAt = 0;

uint32_t lastInteraction = 0;
int tapIndex = 0;
int pokes = 0;
uint32_t lastPokeDecay = 0;
int lastClockHour = -1;

Face lastFace = Face::Count;
uint32_t faceSince = 0;
uint32_t rng = 0x434f434f;  // "COCO"
int wanderX = 0, wanderY = 0;
float gazeX = 0, gazeY = 0;
uint32_t nextWanderAt = 0;
bool napContrast = false;

// touch
bool wasDown = false;
uint32_t pressAt = 0;
bool longFired = false;
bool swallowPress = false;  // the press that woke Coco from a nap is not a tap
bool tapPending = false;
uint32_t lastTapAt = 0;

// battery
int batteryMv = 0;
int batteryPct = 100;
bool batteryPresent = false;
uint32_t nextBatteryAt = 0;
int criticalCount = 0;

// ------------------------------------------------------------------ helpers

bool timeValid() { return time(nullptr) > 1700000000; }

int localHour() {
  if (!timeValid()) return -1;
  time_t t = time(nullptr);
  struct tm tm;
  localtime_r(&t, &tm);
  return tm.tm_hour;
}

bool isNight() {
  int h = localHour();
  if (h < 0) return false;
  return NIGHT_FROM_HOUR > NIGHT_TO_HOUR ? (h >= NIGHT_FROM_HOUR || h < NIGHT_TO_HOUR)
                                         : (h >= NIGHT_FROM_HOUR && h < NIGHT_TO_HOUR);
}

uint32_t napAfter() { return isNight() ? kNightNapMs : kNapMs; }
bool napping(uint32_t now) { return now - lastInteraction > napAfter(); }

void react(Face f, uint32_t ms) {
  uint32_t now = millis();
  reactionFace = f;
  reactionUntil = now + ms;
  activity = Activity::None;
}

void startActivity(Activity a, uint32_t now) {
  activity = a;
  activitySince = now;
  activityUntil = now + kActivities[(int)a].ms;
  nextActivityAt = activityUntil + 25000 + hash32(rng) % 35000;  // 25-60 s later
}

coco::Weather currentWeather(time_t* at = nullptr) {
  portENTER_CRITICAL(&netMux);
  coco::Weather w = weather;
  if (at) *at = weatherAt;
  portEXIT_CRITICAL(&netMux);
  return w;
}

// --------------------------------------------------------------------- LED
// Lights while the head is touched. C3: blue LED on GPIO8 (active LOW).
// HW-747: no plain LED, only a WS2812 RGB LED on GPIO48, so it glows dim green.
void setLed(bool on) {
  static int8_t last = -1;
  if (last == (int8_t)on) return;  // the RGB LED needs a whole data frame per change
  last = on;
#if LED_IS_RGB
  rgbLedWrite(PIN_LED, 0, on ? LED_RGB_LEVEL : 0, 0);
#else
  digitalWrite(PIN_LED, on ? LOW : HIGH);
#endif
}

// -------------------------------------------------------------- deep sleep

void goToSleep() {
  // goodnight face, then screen off
  uint32_t t0 = millis();
  while (millis() - t0 < 1500) {
    canvas.clear();
    canvas.setColor(1);
    FaceCtx ctx;
    ctx.t = millis() - t0;
    drawFace(canvas, Face::Sleeping, ctx);
    oled.show(canvas.buf);
    delay(kFrameMs);
  }
  oled.power(false);
  WiFi.disconnect(true);
  WiFi.mode(WIFI_OFF);
  setLed(false);
  // waking needs the pad released first, otherwise Coco wakes up at once
  while (digitalRead(PIN_TOUCH) == HIGH) delay(10);
  delay(200);
#if CONFIG_IDF_TARGET_ESP32S3
  // S3: wake on the RTC GPIO going HIGH (ext0). Only RTC GPIOs 0-21 can do this.
  esp_sleep_enable_ext0_wakeup((gpio_num_t)PIN_TOUCH, 1);
#else
  // C3: no ext0/ext1, but GPIO0-5 can wake it from deep sleep directly.
  esp_deep_sleep_enable_gpio_wakeup(1ULL << PIN_TOUCH, ESP_GPIO_WAKEUP_GPIO_HIGH);
#endif
  esp_deep_sleep_start();
}

// ------------------------------------------------------------------ battery

int percentFromMv(int mv) {
  // resting Li-ion curve
  static const int kMv[] = {3300, 3500, 3600, 3700, 3750, 3800, 3870, 3950, 4050, 4150};
  static const int kPct[] = {0, 5, 10, 20, 30, 40, 55, 70, 85, 100};
  if (mv <= kMv[0]) return 0;
  for (int i = 1; i < 10; i++) {
    if (mv < kMv[i]) return kPct[i - 1] + (mv - kMv[i - 1]) * (kPct[i] - kPct[i - 1]) / (kMv[i] - kMv[i - 1]);
  }
  return 100;
}

void updateBattery(uint32_t now) {
  if (now < nextBatteryAt) return;
  nextBatteryAt = now + 10000;
  uint32_t sum = 0;
  for (int i = 0; i < 8; i++) sum += analogReadMilliVolts(PIN_BATTERY);
  int mv = (int)(sum / 8 * BATTERY_DIVIDER);
  batteryPresent = mv > 2500;  // below that: no divider fitted / USB only
  if (!batteryPresent) return;
  batteryMv = batteryMv ? (batteryMv * 3 + mv) / 4 : mv;  // smooth
  batteryPct = percentFromMv(batteryMv);
  // protect the cell: two readings under 3.3 V in a row -> sleep
  criticalCount = batteryMv < 3300 ? criticalCount + 1 : 0;
  if (criticalCount >= 2) goToSleep();
}

// --------------------------------------------------------------------- Wi-Fi

void setWifiText(const char* s) {
  portENTER_CRITICAL(&netMux);
  strncpy(wifiText, s, sizeof(wifiText) - 1);
  wifiText[sizeof(wifiText) - 1] = 0;
  portEXIT_CRITICAL(&netMux);
}

void applyTz(int utcOffsetSec) {
  char tz[24];
  coco::posixTz(utcOffsetSec, tz, sizeof(tz));
  if (settings.tz == tz) return;
  settings.tz = tz;
  setenv("TZ", tz, 1);
  tzset();
  saveTz(tz);
  Serial.printf("time zone: %s\n", tz);
}

String urlEncode(const char* s) {
  String o;
  for (; *s; s++) {
    char c = *s;
    if (isalnum((unsigned char)c) || c == '-' || c == '_' || c == '.') {
      o += c;
    } else {
      char b[4];
      snprintf(b, sizeof(b), "%%%02X", (uint8_t)c);
      o += b;
    }
  }
  return o;
}

// HTTPS GET for the OpenWeatherMap calls. The API key is in the URL, so never plain
// HTTP and never printed. The connection is encrypted, but the server certificate is
// not checked (no CA bundle on the board).
int owmGet(const String& url, String& body) {
  WiFiClientSecure client;
  client.setInsecure();
  HTTPClient http;
  http.setTimeout(8000);
  if (!http.begin(client, url)) return -1;
  int code = http.GET();
  if (code == 200) body = http.getString();
  http.end();
  return code;
}

// Looks up the typed city once: OpenWeatherMap geocoding when a key is set,
// otherwise (or if that fails) Open-Meteo geocoding. Both over HTTPS.
void geocode() {
  char place[32];
  portENTER_CRITICAL(&settingsMux);
  memcpy(place, settings.place, sizeof(place));
  portEXIT_CRITICAL(&settingsMux);
  if (settings.owmKey.length()) {  // only changes on the setup page, which restarts Coco
    String body;
    int code = owmGet("https://api.openweathermap.org/geo/1.0/direct?limit=1&q=" + urlEncode(place) +
                          "&appid=" + settings.owmKey,
                      body);
    float lat, lon;
    char name[32];
    if (code == 200 && coco::parseOwmGeocode(body.c_str(), lat, lon, name, sizeof(name))) {
      saveLocation(lat, lon, name[0] ? String(name) : String(place));
      Serial.printf("city (OpenWeatherMap): %s -> %.4f, %.4f\n", name, lat, lon);
      return;
    }
    Serial.printf("city (OpenWeatherMap): HTTP %d%s, trying open-meteo\n", code, code == 401 ? " bad API key" : "");
  }
  String url = "https://geocoding-api.open-meteo.com/v1/search?count=1&format=json&name=" + urlEncode(place);
  WiFiClientSecure client;
  client.setInsecure();  // public data, no secrets sent
  HTTPClient http;
  http.setTimeout(8000);
  if (!http.begin(client, url)) return;
  int code = http.GET();
  float lat, lon;
  char name[32];
  if (code == 200 && coco::parseGeocode(http.getString().c_str(), lat, lon, name, sizeof(name))) {
    saveLocation(lat, lon, name[0] ? String(name) : String(place));
    Serial.printf("city: %s -> %.4f, %.4f\n", name, lat, lon);
  } else {
    Serial.printf("city: '%s' not found (HTTP %d)\n", place, code);
  }
  http.end();
}

// Keeps a new reading for the cards (shared with the drawing code), a copy that
// survives deep sleep, and the time zone of the weather location.
void storeWeather(const coco::Weather& w) {
  time_t now = time(nullptr);
  portENTER_CRITICAL(&netMux);
  weather = w;
  weatherAt = now;
  portEXIT_CRITICAL(&netMux);
  rtcSave = {kRtcMagic, w.tempC, w.hiC, w.loC, (int16_t)w.humidity, (uint8_t)w.sky, (uint8_t)w.isDay,
             (int64_t)now};
  if (w.hasOffset) applyTz(w.utcOffsetSec);
}

// Current weather from OpenWeatherMap (metric units). False on any error, so the
// caller can fall back to open-meteo.
bool fetchOpenWeatherMap(float lat, float lon) {
  char q[96];
  snprintf(q, sizeof(q), "lat=%.4f&lon=%.4f&units=metric&appid=", (double)lat, (double)lon);
  String body;
  int code = owmGet(String("https://api.openweathermap.org/data/2.5/weather?") + q + settings.owmKey, body);
  coco::Weather w;
  bool ok = code == 200 && coco::parseOpenWeatherMap(body.c_str(), w);
  if (ok) storeWeather(w);
  Serial.printf("weather (OpenWeatherMap): HTTP %d %s\n", code,
                ok ? "ok" : code == 401 ? "bad API key, using open-meteo" : "failed, using open-meteo");
  return ok;
}

bool fetchWeather() {
  float lat, lon;
  portENTER_CRITICAL(&settingsMux);
  lat = settings.lat;
  lon = settings.lon;
  portEXIT_CRITICAL(&settingsMux);
  if (settings.owmKey.length() && fetchOpenWeatherMap(lat, lon)) return true;
  char url[256];
  snprintf(url, sizeof(url),
           "http://api.open-meteo.com/v1/forecast?latitude=%.4f&longitude=%.4f"
           "&current=temperature_2m,relative_humidity_2m,weather_code,is_day"
           "&daily=temperature_2m_max,temperature_2m_min&timezone=auto&forecast_days=1",
           (double)lat, (double)lon);
  HTTPClient http;
  http.setTimeout(8000);
  if (!http.begin(url)) return false;
  int code = http.GET();
  bool ok = false;
  if (code == 200) {
    String body = http.getString();
    coco::Weather w;
    if (coco::parseOpenMeteo(body.c_str(), w)) {
      storeWeather(w);
      ok = true;
    }
  }
  Serial.printf("weather (open-meteo): HTTP %d %s\n", code, ok ? "ok" : "failed");
  http.end();
  return ok;
}

void syncOnce() {
  setWifiText("connecting");
  WiFi.mode(WIFI_STA);
  WiFi.begin(settings.ssid.c_str(), settings.pass.c_str());
  uint32_t t0 = millis();
  while (WiFi.status() != WL_CONNECTED && millis() - t0 < 15000) delay(200);
  if (WiFi.status() != WL_CONNECTED) {
    Serial.printf("wifi: could not join '%s'\n", settings.ssid.c_str());
    setWifiText("failed");
    wifiFailed = true;
  } else {
    Serial.printf("wifi: connected, IP %s\n", WiFi.localIP().toString().c_str());
    configTzTime(settings.tz.c_str(), "pool.ntp.org", "time.google.com");
    if (settings.needGeocode) geocode();
    t0 = millis();
    while (!timeValid() && millis() - t0 < 8000) delay(100);
    fetchWeather();
    char s[16] = "ok";
    if (timeValid()) {
      time_t t = time(nullptr);
      struct tm tm;
      localtime_r(&t, &tm);
      strftime(s, sizeof(s), "ok %H:%M", &tm);
    }
    setWifiText(s);
  }
  WiFi.disconnect(true);
  WiFi.mode(WIFI_OFF);  // saves ~60 mA between refreshes
}

void netTask(void*) {
  for (;;) {
    time_t at;
    currentWeather(&at);
    uint32_t refresh = WEATHER_REFRESH_MIN * 60UL;
    uint32_t age = at && timeValid() ? (uint32_t)(time(nullptr) - at) : UINT32_MAX;
    if (!timeValid() || age >= refresh) {
      syncOnce();
      vTaskDelay(pdMS_TO_TICKS(refresh * 1000UL));
    } else {
      vTaskDelay(pdMS_TO_TICKS((refresh - age) * 1000UL + 1000));  // woke from deep sleep with fresh data
    }
  }
}

// ---------------------------------------------------------------- gestures

void noteInteraction(uint32_t now) {
  lastInteraction = now;
  if (napContrast) {
    oled.contrast(OLED_CONTRAST);
    napContrast = false;
  }
}

void onTap(uint32_t now) {
  if (setupMode) return;
  if (menuOpen) {  // next menu item
    menuSel = (menuSel + 1) % (int)MenuItem::Count;
    menuUntil = now + kMenuIdleMs;
    return;
  }
  if (faceShow) {  // next face in the gallery
    faceShowIdx = (faceShowIdx + 1) % (int)Face::Count;
    faceShowSince = now;
    faceShowUntil = now + kCardIdleMs;
    return;
  }
  if (showingCards) {
    card = (Card)(((int)card + 1) % (int)Card::Count);
    cardSince = now;
    cardUntil = now + kCardIdleMs;
    return;
  }
  pokes++;
  if (pokes >= 10) {
    react(Face::Crying, 4000);
  } else if (pokes >= 6) {
    react(Face::Angry, 3500);
  } else {
    tapIndex = (tapIndex + 1) % kTapFaceCount;
    react(kTapFaces[tapIndex], kTapFaceMs);
  }
}

void startSetupMode() {
  // restart into setup, so the hotspot never fights the weather task for the radio
  setupRequest = kSetupMagic;
  canvas.clear();
  drawNotice(canvas, "Wi-Fi setup", "Starting my hotspot...", false);
  oled.show(canvas.buf);
  delay(300);
  ESP.restart();
}

void openMenu(uint32_t now) {
  menuOpen = true;
  showingCards = false;
  faceShow = false;
  menuSel = 0;
  menuUntil = now + kMenuIdleMs;
}

// Hold ~1 s in the menu: open the highlighted item.
void selectMenuItem(uint32_t now) {
  menuOpen = false;
  auto showCard = [&](Card c) {
    showingCards = true;
    card = c;
    cardSince = now;
    cardUntil = now + kCardIdleMs;
  };
  switch ((MenuItem)menuSel) {
    case MenuItem::Clock: showCard(Card::Clock); break;
    case MenuItem::Weather: showCard(Card::Weather); break;
    case MenuItem::Battery: showCard(Card::Status); break;
    case MenuItem::Faces:
      faceShow = true;
      faceShowIdx = 0;
      faceShowSince = now;
      faceShowUntil = now + kCardIdleMs;
      break;
    case MenuItem::WifiSetup: startSetupMode(); break;  // restarts into the QR code + hotspot
    case MenuItem::Sleep: goToSleep(); break;
    default: react(Face::Happy, 1500); break;  // Back
  }
}

void onDoubleTap(uint32_t now) {
  if (setupMode) {
    if (settings.ssid.length()) ESP.restart();  // leave setup, keep the saved Wi-Fi
    return;
  }
  if (menuOpen) {  // close the menu
    menuOpen = false;
    react(Face::Happy, 1500);
  } else {  // from the face, a card or the gallery: (back to) the menu
    openMenu(now);
  }
}

void onLongPress() {
  if (setupMode) return;
  if (menuOpen) {
    menuTookPress = true;
    selectMenuItem(millis());
    return;
  }
  showingCards = false;
  holdingLove = true;
  react(Face::Love, 60000);
}

void onLongRelease() {
  if (menuTookPress) {  // that press opened a menu item, it was not petting
    menuTookPress = false;
    return;
  }
  holdingLove = false;
  reactionUntil = millis() + 1500;  // keep smiling a moment
}

void updateTouch(uint32_t now) {
  bool down = digitalRead(PIN_TOUCH) == HIGH;
  setLed(down);

  if (down && !wasDown) {
    pressAt = now;
    longFired = false;
    swallowPress = napping(now);
    if (swallowPress) react(Face::Yawn, 2800);  // just woke up
    noteInteraction(now);
  }
  if (down) {
    uint32_t held = now - pressAt;
    if (!swallowPress && !longFired && held >= kLongPressMs) {
      longFired = true;
      onLongPress();
    }
    lastInteraction = now;
  }
  if (!down && wasDown) {
    uint32_t held = now - pressAt;
    if (held >= kHoldSetupMs) {
      startSetupMode();
    } else if (held >= kHoldSleepMs && !setupMode) {
      goToSleep();
    } else if (swallowPress) {
      // nothing: that touch only woke Coco up
    } else if (longFired) {
      onLongRelease();
    } else if (tapPending && now - lastTapAt < kDoubleTapMs) {
      tapPending = false;
      onDoubleTap(now);
    } else {
      tapPending = true;
      lastTapAt = now;
    }
  }
  if (tapPending && !down && now - lastTapAt >= kDoubleTapMs) {
    tapPending = false;
    onTap(now);
  }
  wasDown = down;

  // annoyance fades: one poke every 3 s
  if (now - lastPokeDecay > 3000) {
    lastPokeDecay = now;
    if (pokes > 0) pokes--;
  }
}

// ---------------------------------------------------------------- drawing

void drawClockCard(uint32_t t) {
  if (!timeValid()) {
    drawNotice(canvas, "Clock", "No time yet. Hold my head 10 s to set up Wi-Fi", false);
    return;
  }
  time_t now = time(nullptr);
  struct tm tm;
  localtime_r(&now, &tm);
  char date[24];
  strftime(date, sizeof(date), "%a %d %b", &tm);
  drawClock(canvas, tm.tm_hour, tm.tm_min, date, t);
}

void drawWeatherCard(uint32_t t) {
  char place[32];
  portENTER_CRITICAL(&settingsMux);
  memcpy(place, settings.place, sizeof(place));
  portEXIT_CRITICAL(&settingsMux);
  coco::drawWeather(canvas, currentWeather(), place, t);
}

void drawStatusCard() {
  time_t at;
  currentWeather(&at);
  int ageMin = at && timeValid() ? (int)((time(nullptr) - at) / 60) : -1;
  char wifi[16];
  portENTER_CRITICAL(&netMux);
  memcpy(wifi, wifiText, sizeof(wifi));
  portEXIT_CRITICAL(&netMux);
  if (settings.ssid.length() == 0) strcpy(wifi, "not set");
  coco::drawStatus(canvas, batteryPct, batteryPresent ? batteryMv : 0, wifi, ageMin, kVersion);
}

void pickNextActivity(uint32_t now) {
  bool lowBattery = batteryPresent && batteryPct <= 15;
  int weights[kActivityCount] = {0};
  int total = 0;
  for (int i = 1; i < kActivityCount; i++) {
    Activity a = (Activity)i;
    int w = kActivities[i].weight;
    if (a == Activity::Clock && !timeValid()) w = 0;
    if (a == Activity::Weather && !currentWeather().valid) w = 0;
    if (a == Activity::LowBattery && lowBattery) w = 6;
    weights[i] = w;
    total += w;
  }
  rng = hash32(rng + now);
  int pick = total ? (int)(rng % (uint32_t)total) : 0;
  for (int i = 1; i < kActivityCount && total; i++) {
    if (pick < weights[i]) {
      startActivity((Activity)i, now);
      return;
    }
    pick -= weights[i];
  }
}

void render(uint32_t now) {
  canvas.clear();
  canvas.setColor(1);

  if (booting) {
    if (drawBoot(canvas, now - bootAt, kVersion)) booting = false;
    return;
  }

  if (setupMode) {
    drawWifiSetup(canvas, portal::apName.c_str(), portal::kUrl, portal::phoneJoined(), now - setupSince);
    uint32_t held = wasDown ? now - pressAt : 0;
    if (held >= 2000) coco::drawHold(canvas, held);
    return;
  }

  if (wifiFailed) {
    wifiFailed = false;
    noticeUntil = now + 8000;
  }
  if (now < noticeUntil) {
    char msg[64];
    snprintf(msg, sizeof(msg), "Can't join %s. Hold my head 10 s to fix it.", settings.ssid.c_str());
    drawNotice(canvas, "Wi-Fi", msg, true);
    return;
  }

  if (menuOpen) {
    if (now > menuUntil) {
      menuOpen = false;
    } else {
      char clock[8] = "";
      if (timeValid()) {
        time_t tt = time(nullptr);
        struct tm tm;
        localtime_r(&tt, &tm);
        strftime(clock, sizeof(clock), "%H:%M", &tm);
      }
      coco::drawMenu(canvas, kMenuItems, (int)MenuItem::Count, menuSel, clock);
      return;
    }
  }
  if (faceShow) {
    if (now > faceShowUntil) {
      faceShow = false;
    } else {
      FaceCtx ctx;
      ctx.t = now - faceShowSince;
      drawFace(canvas, (Face)faceShowIdx, ctx);
      // name label on a dark strip at the bottom
      char label[32];
      snprintf(label, sizeof(label), "%d/%d %s", faceShowIdx + 1, (int)Face::Count, faceName((Face)faceShowIdx));
      canvas.setColor(0);
      canvas.rect(0, 55, kibo::kWidth, 9);
      canvas.setColor(1);
      canvas.textCentered(64, 56, label, kibo::kFontSmall);
      return;
    }
  }

  if (showingCards) {
    if (now > cardUntil) {
      showingCards = false;
    } else {
      uint32_t t = now - cardSince;
      if (card == Card::Clock) drawClockCard(t);
      else if (card == Card::Weather) drawWeatherCard(t);
      else drawStatusCard();
      return;
    }
  }

  // hourly clock
#if HOURLY_CLOCK
  if (timeValid() && !napping(now)) {
    time_t tt = time(nullptr);
    struct tm tm;
    localtime_r(&tt, &tm);
    if (tm.tm_min == 0 && tm.tm_hour != lastClockHour && now >= reactionUntil) {
      lastClockHour = tm.tm_hour;
      startActivity(Activity::Clock, now);
    }
  }
#endif

  Face face = Face::Neutral;
  bool asleep = napping(now);
  if (now < reactionUntil) {
    face = reactionFace;
  } else if (activity != Activity::None && now < activityUntil) {
    uint32_t t = now - activitySince;
    switch (activity) {
      case Activity::Eating: face = Face::Eating; break;
      case Activity::Playing: face = Face::Playing; break;
      case Activity::Music: face = Face::Music; break;
      case Activity::Sing: face = Face::Singing; break;
      case Activity::Yawn: face = Face::Yawn; break;
      case Activity::LowBattery: face = Face::LowBattery; break;
      case Activity::Clock: drawClockCard(t); return;
      case Activity::Weather: drawWeatherCard(t); return;
      default: break;
    }
  } else {
    activity = Activity::None;
    if (asleep) face = Face::Sleeping;
    else if (now >= nextActivityAt) pickNextActivity(now);
  }

  // dim while asleep
  if (asleep != napContrast) {
    oled.contrast(asleep ? OLED_CONTRAST_NAP : OLED_CONTRAST);
    napContrast = asleep;
  }

  // idle gaze wandering
  if (now >= nextWanderAt) {
    rng = hash32(rng ^ now);
    bool centre = (rng & 3) == 0;
    wanderX = centre ? 0 : (int)(rng % 13) - 6;
    wanderY = centre ? 0 : (int)((rng >> 8) % 7) - 3;
    nextWanderAt = now + 1500 + (rng >> 16) % 2500;
  }
  bool wander = face == Face::Neutral || face == Face::Serious || face == Face::Cute;
  gazeX += ((wander ? wanderX : 0) - gazeX) * 0.3f;
  gazeY += ((wander ? wanderY : 0) - gazeY) * 0.3f;

  if (face != lastFace) {
    lastFace = face;
    faceSince = now;
  }
  FaceCtx ctx;
  ctx.t = now - faceSince;
  ctx.lookX = (int)gazeX;
  ctx.lookY = (int)gazeY;
  if (ctx.t < kBlinkMs) drawBlink(canvas, ctx);
  else drawFace(canvas, face, ctx);

  // overlays
  uint32_t held = wasDown ? now - pressAt : 0;
  if (held >= 2000) coco::drawHold(canvas, held);
  if (batteryPresent && batteryPct <= 20) {
    canvas.setColor(0);
    canvas.rect(112, 0, 16, 9);
    canvas.setColor(1);
    drawBatteryIcon(canvas, 114, 1, batteryPct, false);
  }
}

void flush() {
  if (haveSent && memcmp(lastSent, canvas.buf, sizeof(lastSent)) == 0) return;  // unchanged
  oled.show(canvas.buf);
  memcpy(lastSent, canvas.buf, sizeof(lastSent));
  haveSent = true;
}

// --------------------------------------------------------------- main

void setup() {
  setCpuFrequencyMhz(80);  // plenty for 25 fps faces, ~30% less current than 160 MHz
  Serial.begin(115200);
  pinMode(PIN_TOUCH, INPUT);  // TTP223 drives the line itself
#if !LED_IS_RGB
  pinMode(PIN_LED, OUTPUT);
#endif
  setLed(false);
  analogSetPinAttenuation(PIN_BATTERY, ADC_11db);
  loadSettings();
  setenv("TZ", settings.tz.c_str(), 1);  // local time also right after a deep sleep
  tzset();

  bool fromSleep = esp_sleep_get_wakeup_cause() != ESP_SLEEP_WAKEUP_UNDEFINED;
  if (rtcSave.magic == kRtcMagic) {
    weather.valid = true;
    weather.tempC = rtcSave.temp;
    weather.hiC = rtcSave.hi;
    weather.loC = rtcSave.lo;
    weather.humidity = rtcSave.humidity;
    weather.sky = (coco::Sky)rtcSave.sky;
    weather.isDay = rtcSave.day;
    weatherAt = (time_t)rtcSave.fetchedAt;
  }

  if (!oled.begin(PIN_SDA, PIN_SCL, OLED_ADDR, OLED_ROTATE_180, OLED_CONTRAST))
    Serial.println("OLED not found - check SDA/SCL and address 0x3C");

  uint32_t now = millis();
  bootAt = now;
  lastInteraction = now;
  nextActivityAt = now + 30000;
  booting = !fromSleep;
  if (fromSleep) react(Face::Yawn, 2800);
  updateBattery(now);

  setupMode = setupRequest == kSetupMagic || settings.ssid.length() == 0;
  setupRequest = 0;
  if (setupMode) {
    booting = false;
    setupSince = now;
    portal::begin();
  } else {
    xTaskCreate(netTask, "coco_net", 8192, nullptr, 1, nullptr);
  }
  Serial.printf("Coco Touch %s on %s, %s ready (%s%s)\n", kVersion, BOARD_NAME,
                OLED_SH1106 ? "SH1106" : "SSD1306", fromSleep ? "woke from sleep" : "power on",
                setupMode ? ", Wi-Fi setup" : "");
}

void loop() {
  static uint32_t last = millis();
  uint32_t now = millis();
  if (setupMode) {
    portal::loop();
    lastInteraction = now;  // no naps while setting up
    if (settings.ssid.length() && now - setupSince > 15 * 60000UL) ESP.restart();  // gave up: back to normal
  }
  if (!booting) updateTouch(now);
  updateBattery(now);
  if (kDeepSleepMs && napping(now) && now - lastInteraction > napAfter() + kDeepSleepMs) goToSleep();
  render(now);
  flush();
  uint32_t spent = millis() - last;
  delay(spent < kFrameMs ? kFrameMs - spent : 1);
  last = millis();
}
