smartrobolab/Coco_Desk_Buddy/coco_touch_advance/yeti/firmware/coco_yeti/coco_cards.h

// Coco's info cards: weather, status and the long-press overlay.
//
// Like kibo_screens, no Arduino/ESP-IDF dependency: sim/ renders these on a PC.
#pragma once
#include <stdint.h>

#include "kibo_canvas.h"

namespace coco {

using kibo::Canvas;

enum class Sky : uint8_t { Unknown, Clear, PartlyCloudy, Cloudy, Fog, Drizzle, Rain, Snow, Thunder };

struct Weather {
  bool valid = false;
  float tempC = 0;
  float hiC = 0, loC = 0;
  int humidity = 0;
  Sky sky = Sky::Unknown;
  bool isDay = true;
  bool hasOffset = false;
  int utcOffsetSec = 0;  // local time offset at the weather location, DST included
};

// WMO weather interpretation code (Open-Meteo "weather_code") -> Sky.
Sky skyFromWmo(int code);
const char* skyName(Sky s);

// Parses an Open-Meteo /v1/forecast response requested with
// current=temperature_2m,relative_humidity_2m,weather_code,is_day and
// daily=temperature_2m_max,temperature_2m_min. Returns false if fields are missing.
bool parseOpenMeteo(const char* json, Weather& out);

// OpenWeatherMap condition id ("weather":[{"id":...}]) -> Sky.
Sky skyFromOwm(int id);

// Parses an OpenWeatherMap /data/2.5/weather response requested with units=metric:
// temperature, today's range (main.temp_min/max), humidity, condition, day/night
// (icon ends in 'd'/'n') and the place's UTC offset ("timezone"). False if fields are missing.
bool parseOpenWeatherMap(const char* json, Weather& out);

// Parses an OpenWeatherMap geocoding response (/geo/1.0/direct?q=...&limit=1):
// first result's lat, lon and name. Returns false if there is no result.
bool parseOwmGeocode(const char* json, float& lat, float& lon, char* name, int nameLen);

// Parses an Open-Meteo geocoding response (/v1/search?name=...&count=1):
// first result's latitude, longitude and name. Returns false if there is no result.
bool parseGeocode(const char* json, float& lat, float& lon, char* name, int nameLen);

// POSIX TZ string for a fixed UTC offset, e.g. 32400 -> "<+0900>-9:00".
void posixTz(int utcOffsetSec, char* out, int outLen);

// Animated weather icon, about 40x40 px around (cx, cy).
void drawWeatherIcon(Canvas& c, int cx, int cy, Sky sky, bool day, uint32_t t);

// Full weather card. `place` is a short label such as "Tokyo".
void drawWeather(Canvas& c, const Weather& w, const char* place, uint32_t t);

// Status card: battery, Wi-Fi and how old the weather is.
//   batteryMv <= 0: no battery measured
//   wifi: "ok 10:32", "off", "not set"...   weatherAgeMin < 0: never fetched
void drawStatus(Canvas& c, int batteryPct, int batteryMv, const char* wifi, int weatherAgeMin,
                const char* version);

// Menu: a title bar with `clock` ("14:05", or empty) on the right and a list of
// `count` items that scrolls so the `selected` one (drawn inverted) stays visible.
void drawMenu(Canvas& c, const char* const* items, int count, int selected, const char* clock);

// Long-press overlay at the bottom: 2-5 s "keep holding: sleep", 5-10 s "let go = sleep,
// hold = Wi-Fi", 10 s+ "let go = Wi-Fi setup".
void drawHold(Canvas& c, uint32_t heldMs);

}  // namespace coco
