smartrobolab/Coco_Desk_Buddy/(commit log)

2026-11-02 Add Coco Touch and Coco Voice: firmware, circuit diagrams, brass case and assembly guides
    - firmware/coco_touch: Arduino sketch for ESP32-C3 + SSD1306 + TTP223 with Kibo's
    face engine, clock, Open-Meteo weather, status card, touch gestures, deep sleep
    - firmware/coco_voice: XiaoZhi custom board (coco/c3) reusing Kibo's voice board code
    with a 0.96" SSD1306 and no IMU, plus build/flash/install scripts
    - sim: PC renderer for faces and cards and a weather parser self-test
    - tools/make_diagrams.py: wiring diagrams, dimensioned brass cases, assembly steps,
    overview and a 1:1 bending template
    - README and docs/brass-build.md
2026-11-02 Add phone Wi-Fi setup, Coco Voice S3 (Hey Coco), LDO power, STL models; one folder per version
    - Coco Touch: Wi-Fi, password and city set from a phone (hotspot + QR + captive page),
    saved in flash; time zone learned from the weather location; city lookup via
    Open-Meteo geocoding; hold 10 s = Wi-Fi setup; big drawn COCO logo
    - Coco Voice S3: XIAO ESP32S3 board config with the custom "hey coco" wake word,
    8 MB partition table, build.sh c3|s3, calm-voice agent setup guide
    - Power: external 3.3 V LDO (ME6211 / RT9080) feeds the 3V3 pin in all versions
    - tools/make_stl.py: full and frame-only STL models for each version
    - Repo split into coco_touch/, coco_voice_c3/, coco_voice_s3/ and share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
    [coco_8m.csv, coco_touch_frame.stl, coco_touch_full.stl, coco_voice_c3_frame.stl, coco_voice_c3_full.stl, coco_voice_s3_frame.stl, coco_voice_s3_full.stl]
2026-11-02 Give each Coco version its own firmware folder; add tested voice firmware builds
    - coco_touch/firmware, coco_voice_c3/firmware and coco_voice_s3/firmware are each
    complete on their own (own build.sh, installer, shared code); tools/sync_shared.sh
    keeps the copied face engine and voice code identical
    - Voice firmware built in Docker (espressif/idf v6.1, XiaoZhi d395220): coco/c3 and
    coco/s3 ("hey coco" custom wake word, PSRAM, 8 MB) both compile with 0 warnings
    - Ready-to-flash merged binaries in coco_voice_c3/firmware/release and
    coco_voice_s3/firmware/release
    - build.sh: JOBS=N limits CPU cores so the build fits in Docker Desktop's memory
    [coco_8m.csv]
2026-11-02 Add size and dimensioned case diagrams for each Coco version
    - <version>_size.png: outer size in three views, every part's real size and position,
    bank-card scale comparison
    - <version>_case_dimensions.png: every brass frame bar dimensioned, plus a cut list
    with wire gauge, length, quantity and bends
    - READMEs show both diagrams
2026-11-02 Add photo-style Blender renders of each Coco version
    - tools/render_realistic.py + tools/blender_coco.py: Cycles renders built from the
    same case data as the drawings: brass wire with solder joints, real-size modules
    (OLED showing Coco's face from the firmware, ESP32-C3 / XIAO S3, TP4056, 16340,
    TTP223, amp, mic, speaker) on a green cutting mat
    - <version>/images/<version>_render.png and _render_back.png, and
    shared/images/coco_family_render.png (true relative size)
    - READMEs show the renders at the top
2026-11-02 Add ESP32-S3 Super Mini (4 MB) build with 1.3" OLED; Super Mini and DevKitC wiring diagrams
    The Super Mini's 4 MB flash can't hold the app plus the "Hey Coco" MultiNet
    model, so SIMPLE=1 build.sh builds coco-s3-4mb: "Hi ESP" wake word, quad
    PSRAM, XiaoZhi 4 MB partitions, SH1106 1.3" OLED and the RGB LED on GPIO48.
    The 8 MB XIAO build is unchanged.
2026-11-02 Name the Super Mini firmware and wiring diagram after the HW-747 board
2026-11-03 S3: 330k/330k battery divider, HW-747 case and test guide
    - Battery sense on the S3 builds is now 330k + 330k (Vbat/2 at GPIO2);
    firmware divider constant, wiring diagrams (resistor colour bands drawn
    from the value) and both S3 release binaries rebuilt to match.
    - HW-747 (ESP32-S3 Super Mini, 1.3" OLED) brass case: 58 x 44 x 30 mm
    design with part placement, cut list, assembly steps, bending template
    and STL.
    - TESTING.md: multimeter checks and a step-by-step bench test, with the
    coco_hw747_test sketch and two test sheets (tools/make_test_diagrams.py).
    [coco_voice_s3_hw747_esp32s3_frame.stl, coco_voice_s3_hw747_esp32s3_full.stl]
2026-11-03 Coco Touch: ESP32-S3 HW-747 support and 1.3" SH1106 screen option
    Four builds, each a merged binary flashable at 0x0 (coco_touch/firmware/release):
    C3 Super Mini or HW-747, each with a 0.96" SSD1306 or a 1.3" SH1106.
    - coco_config.h: one section per board, picked by the chip (C3: SDA 4, SCL 5,
    touch 0, 1M/330k divider on GPIO1, blue LED 8; HW-747: SDA 5, SCL 6,
    touch 1, 330k/330k on GPIO2, RGB LED 48) and one OLED_SH1106 switch.
    - coco_oled.h: SH1106 path (column offset 2, page addressing, DC-DC 0xAD);
    the SSD1306 path is unchanged.
    - coco_touch.ino: S3 deep-sleep wake via ext0 on RTC GPIO1, setLed() for the
    C3's blue LED or the HW-747's WS2812.
    - build.sh builds all four (or some b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
2026-11-03 Coco Voice: choose the screen per build (0.96" SSD1306 or 1.3" SH1106)
    The screen used to follow the flash size (4 MB = SH1106). Now each build in
    boards/coco/<v>/config.json picks it with CONFIG_COCO_OLED_SH1106, a Kconfig
    option that install_coco.py adds to XiaoZhi; config.h turns it into
    KIBO_OLED_SH1106 for the shared display code.
    Builds and ready-made binaries (release/, flash at 0x0):
    - C3 Super Mini: coco-c3 (0.96") -> coco_voice_c3_096, coco-c3-13 (1.3") -> coco_voice_c3_13
    - S3 HW-747 (4 MB, "Hi ESP"): coco-s3-4mb-096 (0.96") -> coco_voice_s3_hw747_096,
    coco-s3-4mb (1.3") -> coco_voice_s3_hw747_13
    - XIAO ESP32S3 (8 MB, "Hey Coco"): coco-s3, unchanged
    build.sh takes BUILD=<name>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
2026-11-03 README: firmware table for every board and screen
    Coco Touch and Coco Voice on the ESP32-C3 Super Mini and the ESP32-S3
    HW-747, each with a 0.96" or 1.3" OLED: one ready-made file per cell.
2026-11-03 Coco Touch: menu, OpenWeatherMap weather, face gallery
    - Double-tap opens a menu (Clock & date, Weather, Battery, Faces, Wi-Fi
    setup with QR, Sleep, Back): tap = next item, hold ~1 s = open it,
    double-tap = close. Cards and the new face gallery go back to the menu.
    - Weather and city lookup from OpenWeatherMap when an API key is set (phone
    setup page or a git-ignored coco_secrets.h), over HTTPS and never logged;
    open-meteo stays the fallback and the default without a key.
    - build.sh keeps keys out of the public release files (COCO_NO_SECRETS);
    PRIVATE=1 builds with coco_secrets.h into the ignored private/ folder.
    - coco_cards: parseOpenWeatherMap, parseOwmGeocode, skyFromOwm, drawM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
2026-11-04 Coco Yeti: motion sensor + vibration firmware, case tools for the yeti
    Firmware (coco_touch_advance/yeti/firmware/coco_yeti), Coco Touch Advance plus:
    - coco_motion: falls (and landed / caught), shakes, knocks (real slaps),
    spins, moved, orientation (upright, upside down, on its back, face down,
    on a side) from 100 Hz samples; PC test tools/test_motion.cpp, 13 cases.
    - coco_imu: MPU6050 / MPU65xx on the OLED's I2C bus, FIFO read each frame,
    axis matrix (config default or measured by Settings > Motion setup),
    wake-on-motion INT on GPIO3 for deep sleep.
    - coco_vibe: vibration patterns on GPIO10 (tap, purr, giggle, thump, alarm,
    rumble, hello, game over), Off / Soft / Strong.
    - Reacti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
    [coco_cards.cpp, coco_cards.h, coco_config.h, coco_faces_x.cpp, coco_faces_x.h, coco_games.cpp, coco_games.h, coco_imu.h]
2026-11-04 Coco Yeti 403035: thin 4.0 x 30 x 35 mm battery, 21 x 23 mm vibration motor
    New folder coco_touch_advance/yeti_403035 (the yeti folder is unchanged):
    - make_yeti.py: inside rearranged for a 4.0 mm LiPo and the black 21 x 23 mm
    DC vibration motor module: the ESP32-C3 stands at the head end of the back
    (USB-C slot moved there, the zip's slot filled back to the cover's dome),
    the battery lies flat on the back cover, the switch sits at the feet end,
    the MPU6050 fin moves next to the ESP32. Fit check passes for both screens.
    - A 4.0 x 30 x 48 mm battery does not fit anywhere in the yeti with 1 mm
    clearance (longest 30 mm wide: 46 mm empty); with all parts and the switch
    the longest is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
    [make_yeti.py, render_blender.py, render_yeti.py]
2026-11-04 Coco Yeti: part-by-part assembly guides for both versions
    - tools/render_steps.py (yeti and yeti_403035): 11 assembly steps, each a
    picture from the real STL geometry (new part in colour sliding in along an
    arrow, fitted parts grey) with its instructions, written to
    images/assembly/ and ASSEMBLY.md.
    - coco_yeti_bottom.png explains the zip design's bottom: the open arch
    between the legs, the stepped holes through each leg (8.8 mm x 3.5 mm,
    then 6 mm into the body, 30 mm apart over the base's marks: for
    magnets / pins / screws to hold the yeti on its base) and the 23 x 23 mm
    recess in the inside floor with a 2 mm hole (most likely the original
    vibration-motor seat; unused by Co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
    [render_steps.py]
2026-11-04 Coco Yeti: 403048 (1.12x) and 2 x 502030 versions, heavy legs, print guide
    Two new folders (the yeti and yeti_403035 folders are unchanged):
    - yeti_403048: the 4.0 x 30 x 48 mm LiPo does not fit the yeti at its size
    with 1 mm clearance, so the whole yeti is scaled 1.12x (smallest that
    fits, searched 1.04-1.12). Battery flat on the back cover, ESP32-C3 on
    edge at the left with its USB-C slot moved there, switch right of it.
    - yeti_2x502030: original size; two 5 x 20 x 30 mm cells stacked at the head
    end, charger on top, ESP32-C3 in the zip's own USB-C slot.
    Both: solid legs (the zip's stepped holes filled) with M3 pilot holes, base
    with two countersunk holes for M3 x 12 screws; chassi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
    [make_yeti.py, render_blender.py, render_steps.py, render_yeti.py, verify_print.py]
2026-11-04 Coco Yeti 403048 / 2x502030: charger port on the back, room for big plug heads
    - The TP4056 charger now stands with its own USB-C through the back cover,
    so the battery is charged from outside (403048: on edge right of the
    battery near the head end, one chassis leg moved; 2x502030: across the
    feet end next to the ESP32-C3). Positions found by a search of the free
    space with 1 mm round every part.
    - Both USB-C ports get a slot plus a deep 15 x 9 mm outside recess, leaving
    only 0.6 mm between the plug head and the socket, so big / coated plug
    heads seat fully (the plug's metal is 6.65 mm). The zip's own port left
    1.66 mm, too thick for a full insertion.
    - The ESP32's 5V no longer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
    [make_yeti.py, render_steps.py, render_yeti.py, verify_print.py]
2026-11-04 Coco Yeti 403048: Blender filament looks (white, beige, blue, marble, luminous rainbow) for colour choice
2026-11-04 Coco Yeti: CAD files, images, printing guide and v1.2 STLs
    [coco_yeti_back_cover.stl, coco_yeti_base_plain.stl, coco_yeti_bezel_096.stl, coco_yeti_bezel_13.stl, coco_yeti_body.stl, coco_yeti_chassis_096.stl, coco_yeti_chassis_13.stl, coco_yeti_parts_096.stl]
